jaggies/matchbox/images/matchbox_cpu_v20rt.png

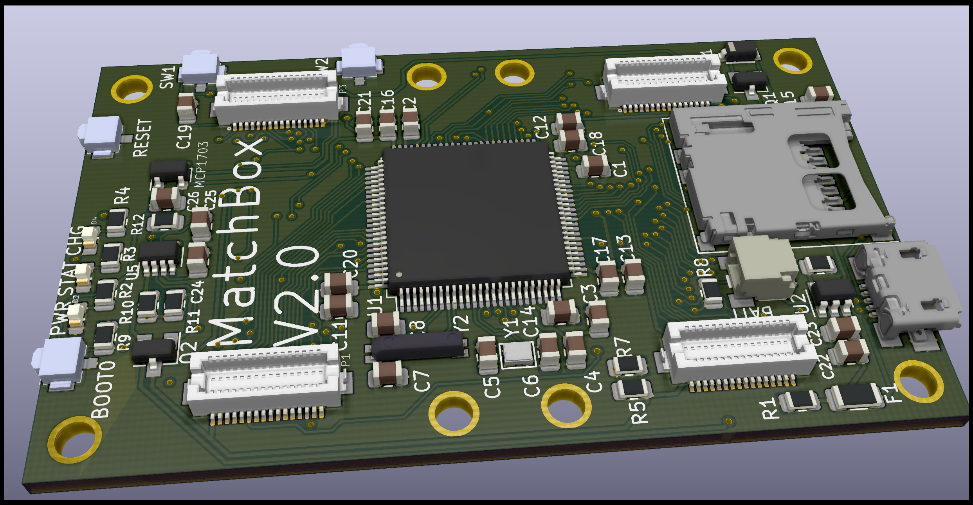
images/matchbox_cpu_v20rt.png
