jaggies/matchbox/images/matchbox_cpu_v20.png

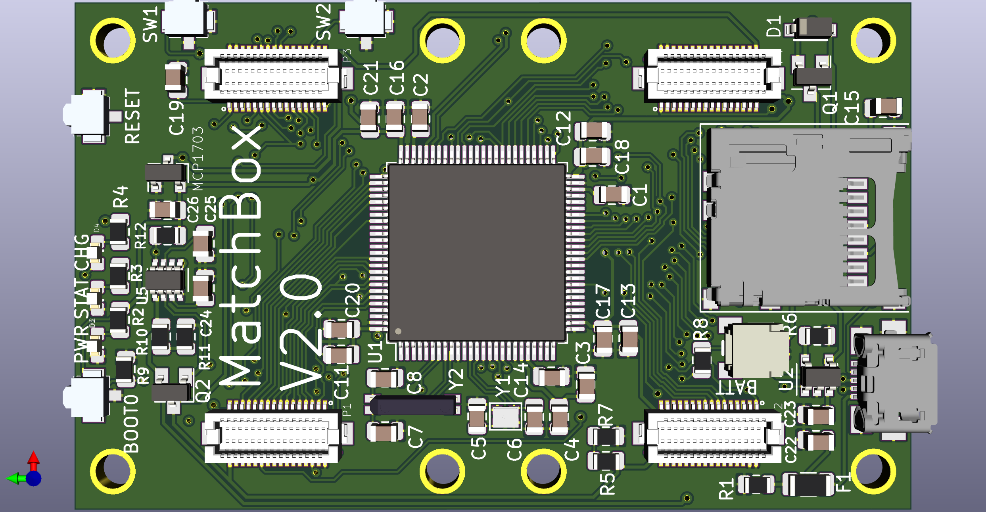
images/matchbox_cpu_v20.png
