jaggies/matchbox/target/stm32f4xx/stm32f415/README

This directory contains the output of STM32CubeMX code generation, less libraries that
are build by the rest of the build system.
