jaggies/matchbox/images/drills.png

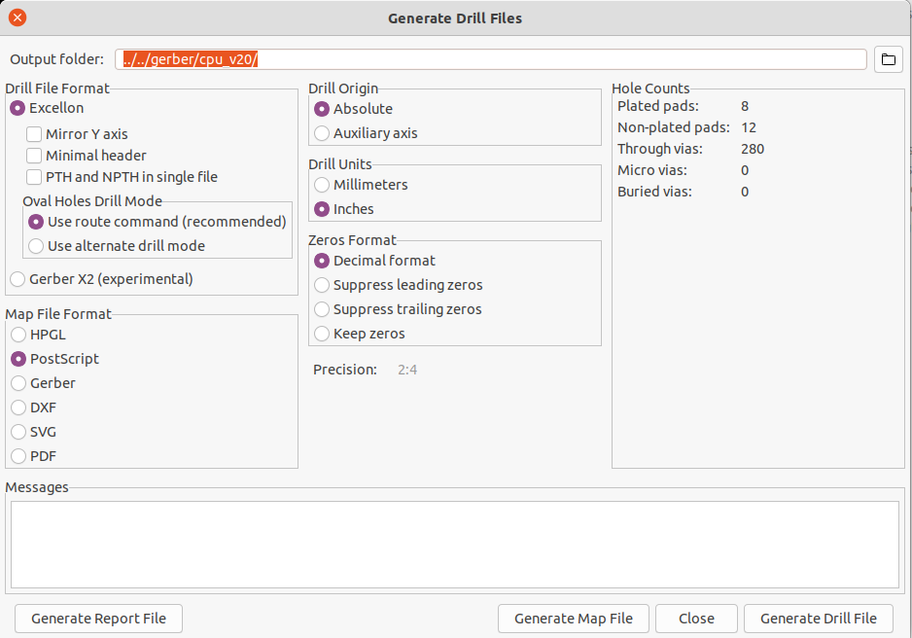
images/drills.png
