jaggies/matchbox/images/gerber.png

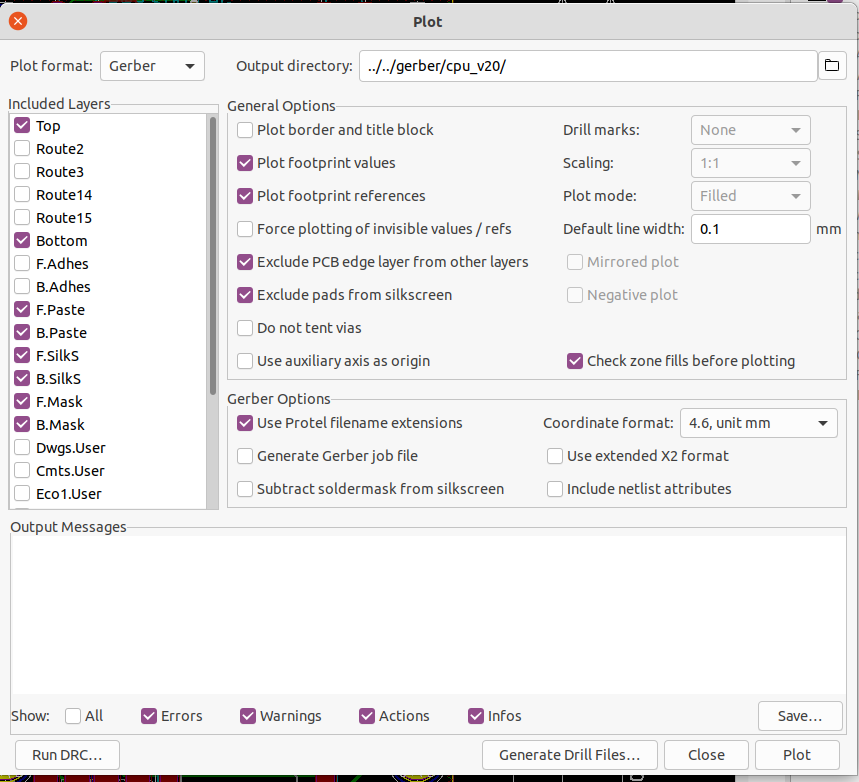
images/gerber.png
