jaggies/matchbox/cad/case/no_battery.FCStd

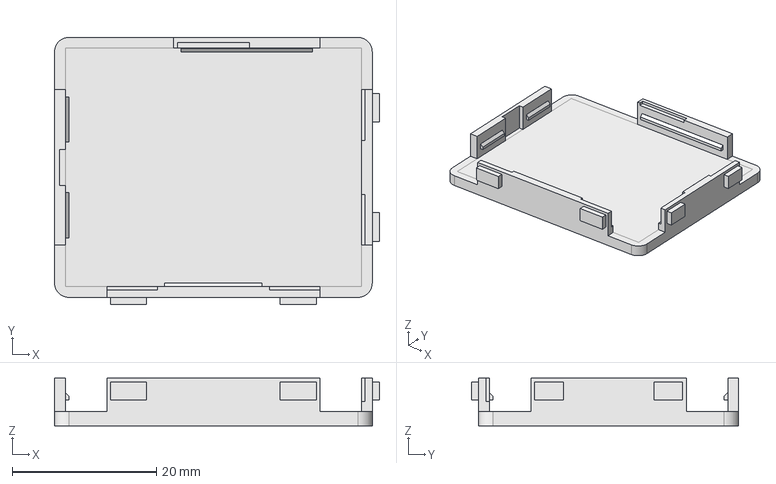
[picture p5: CAD file, 2020-05-25]
cad/case/no_battery.FCStd
45.0 x 37.0 x 6.60 mm
