jaggies/matchbox/cad/pcb/kicad/3dshapes/ABM11.STEP

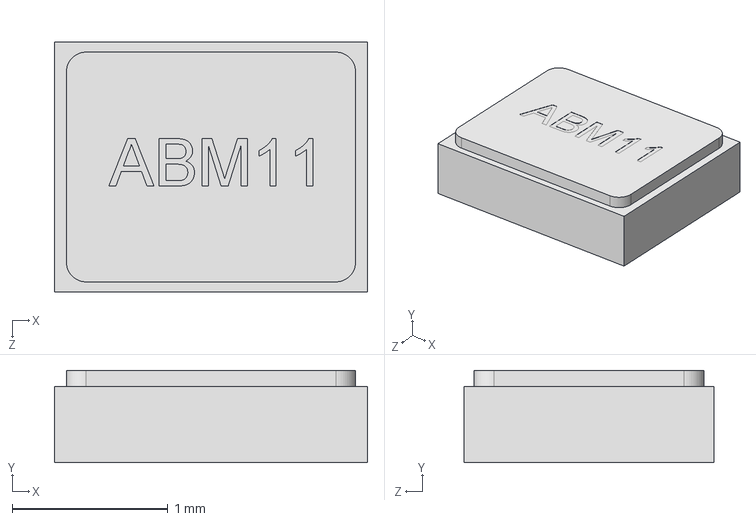
[picture p6: CAD file, 2020-07-05]
cad/pcb/kicad/3dshapes/ABM11.STEP
2.01 x 0.59 x 1.60 mm
