jaggies/matchbox/cad/case/new_corner.FCStd

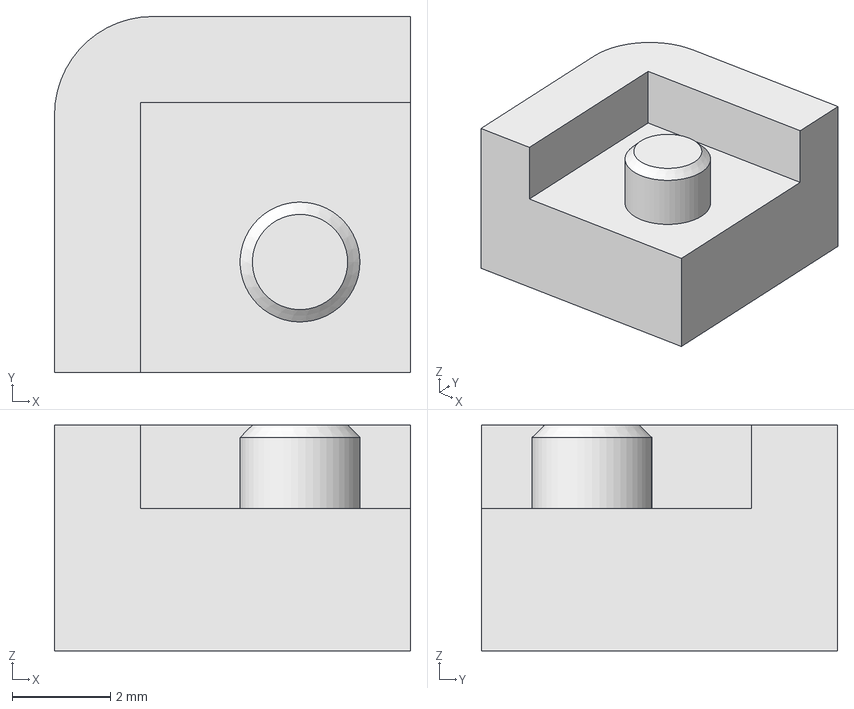
[picture p7: CAD file, 2020-05-25]
cad/case/new_corner.FCStd
7.25 x 7.25 x 4.60 mm
