jaggies/matchbox/cad/pcb/kicad/3dshapes/DF12-32DS-0.5V.stp

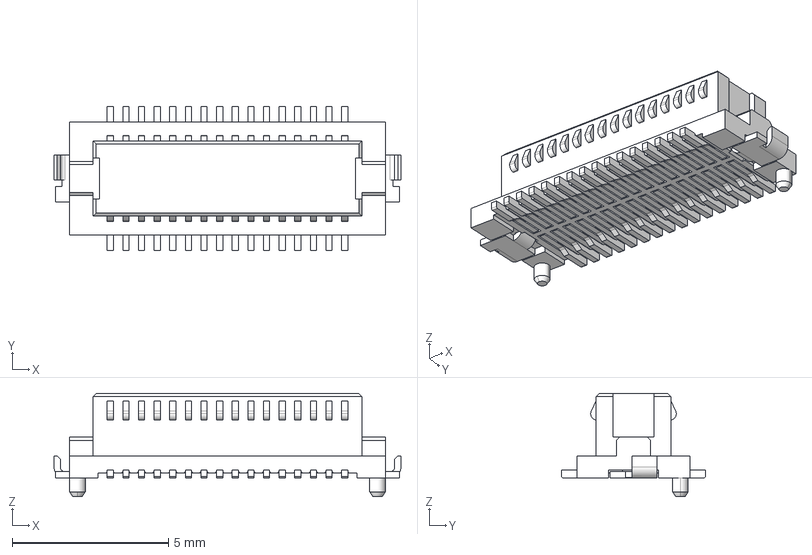
[picture p8: CAD file, 2020-07-05]
cad/pcb/kicad/3dshapes/DF12-32DS-0.5V.stp
11.1 x 4.60 x 3.30 mm
