jaggies/matchbox/cad/case/peg_corner.FCstd

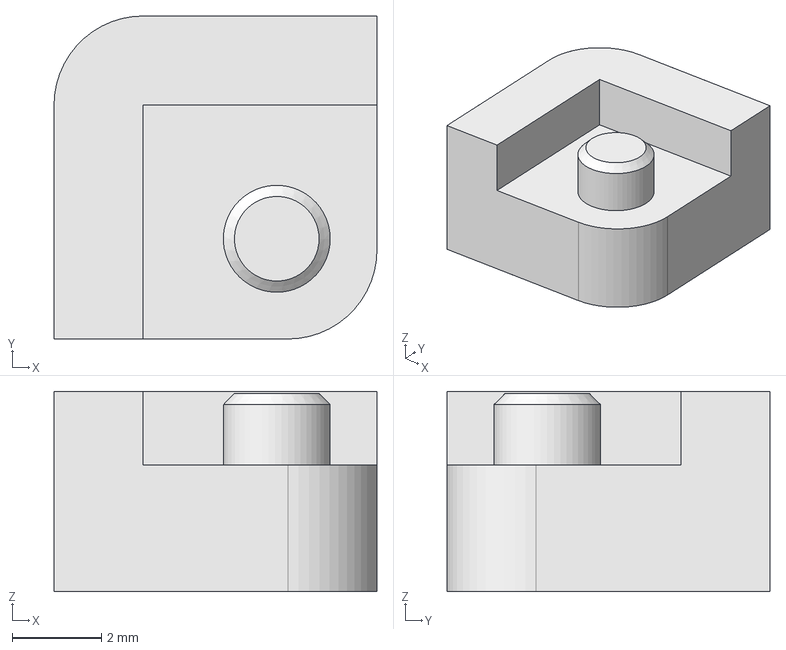
[picture p9: CAD file, 2020-05-25]
cad/case/peg_corner.FCstd
7.25 x 7.25 x 4.50 mm
