jaggies/matchbox/cad/pcb/kicad/3dshapes/SM02B-SRSS-TB_white.STEP

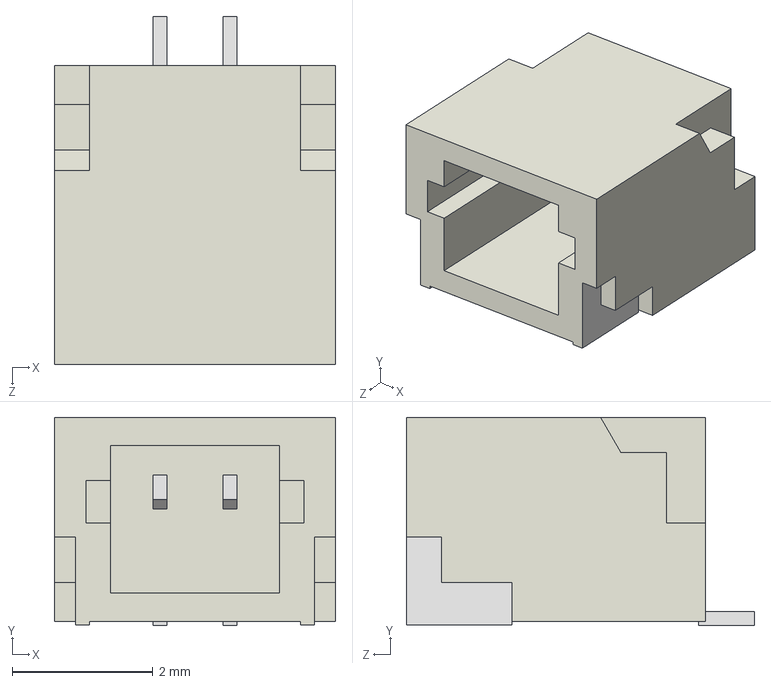
[picture p10: CAD file, 2020-07-05]
cad/pcb/kicad/3dshapes/SM02B-SRSS-TB_white.STEP
4.00 x 2.96 x 4.95 mm
