jaggies/matchbox/cad/case/display.FCStd

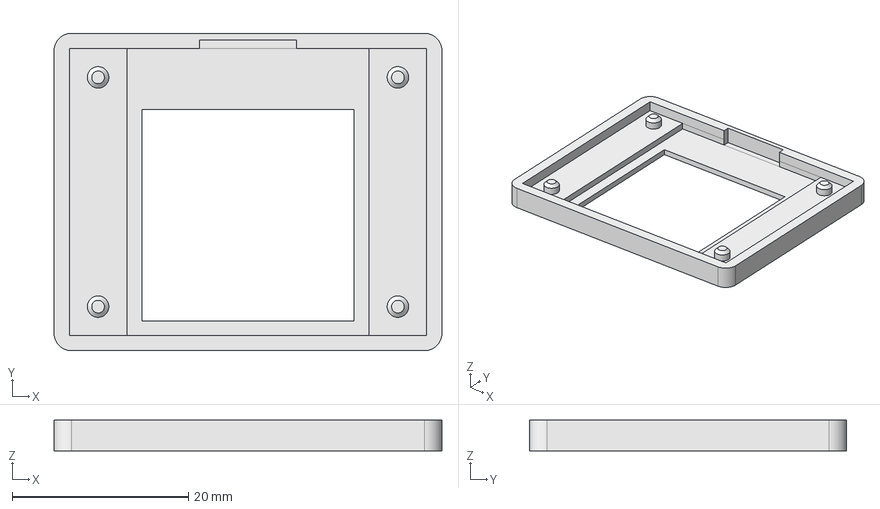
[picture p11: CAD file, 2020-05-25]
cad/case/display.FCStd
44.0 x 36.0 x 3.50 mm
