jaggies/matchbox/cad/case/new_battery.FCStd

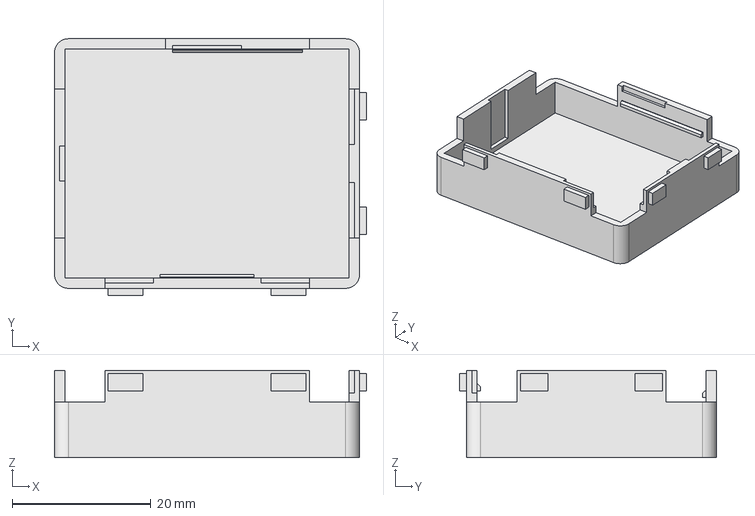
[picture p12: CAD file, 2020-05-25]
cad/case/new_battery.FCStd
45.0 x 37.0 x 12.6 mm
