jaggies/matchbox/cad/pcb/kicad/3dshapes/DF12(3.0)-32DP-0.5V.stp

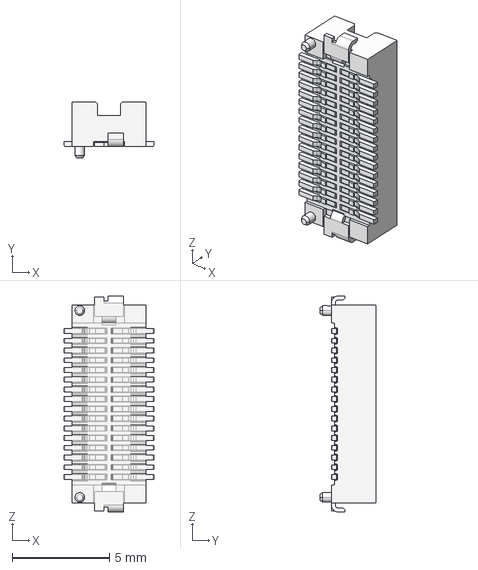
[picture p13: CAD file, 2020-07-05]
cad/pcb/kicad/3dshapes/DF12(3.0)-32DP-0.5V.stp
4.60 x 2.90 x 11.1 mm
