jaggies/matchbox/cad/pcb/kicad/3dshapes/b3u_B3U-3100P(M)-B.igs

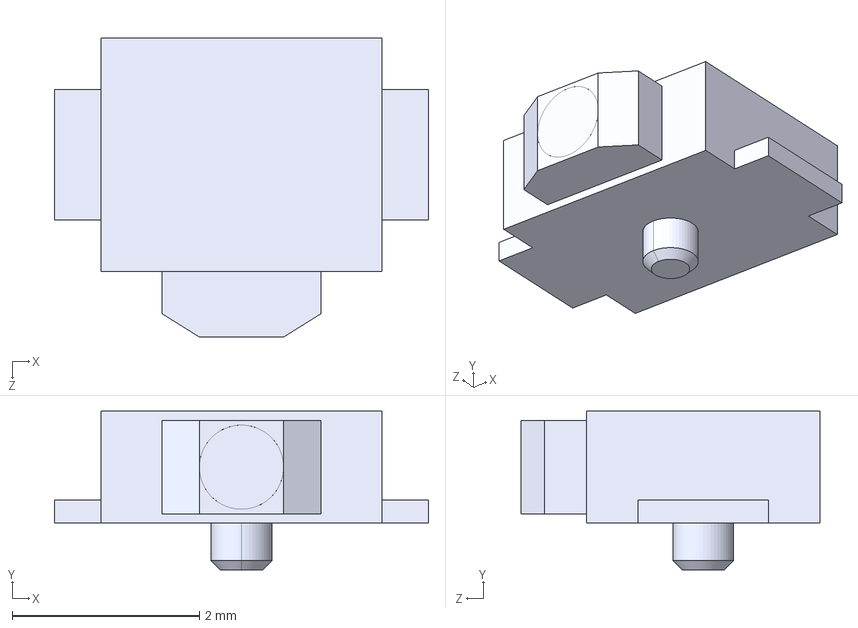
[picture p14: CAD file, 2020-07-05]
cad/pcb/kicad/3dshapes/b3u_B3U-3100P(M)-B.igs
4.00 x 1.70 x 3.20 mm
