jaggies/matchbox/cad/pcb/kicad/3dshapes/10118192C.stp

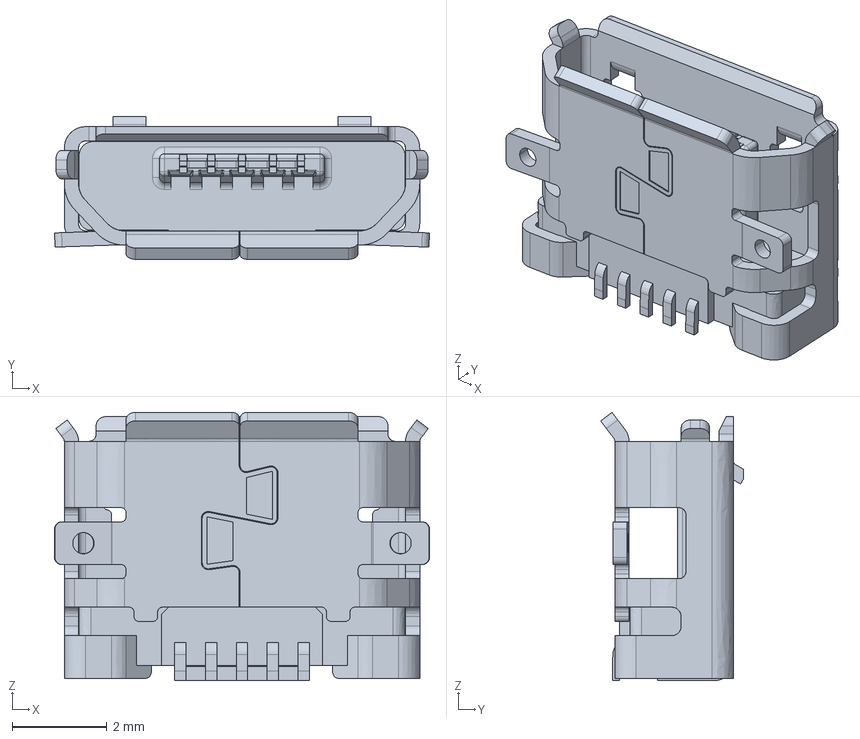
[picture p15: CAD file, 2020-07-05]
cad/pcb/kicad/3dshapes/10118192C.stp
7.91 x 3.01 x 5.66 mm
