jaggies/matchbox/cad/pcb/kicad/3dshapes/5025700893.stp

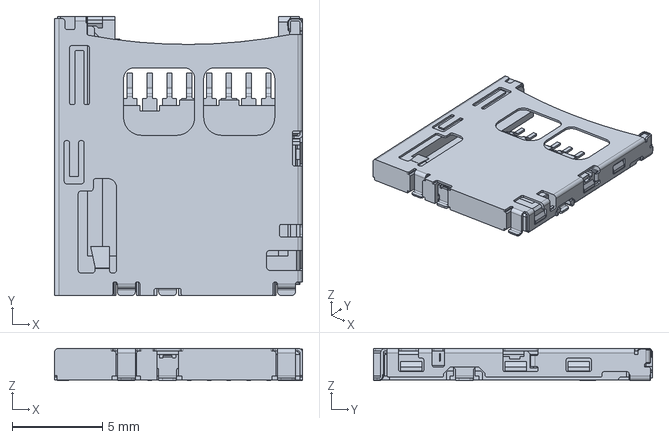
[picture p16: CAD file, 2020-07-05]
cad/pcb/kicad/3dshapes/5025700893.stp
13.8 x 15.5 x 1.80 mm
