jaggies/matchbox/(list of files, cad)

Other CAD files:
cad/pcb/kicad/3dshapes/SM02B-SRSS-TB.STEP
cad/case/battery.FCStd
cad/case/screw_corner.FCStd
cad/pcb/kicad/3dshapes/SM02B-SRSS-TB.IGS
