jaggies/matchbox/cad/pcb/kicad/cpu/v2.0/matchbox_cpu_v20.kicad_pcb

## KiCad design cad/pcb/kicad/cpu/v2.0/matchbox_cpu_v20.kicad_pcb (2020-07-22)

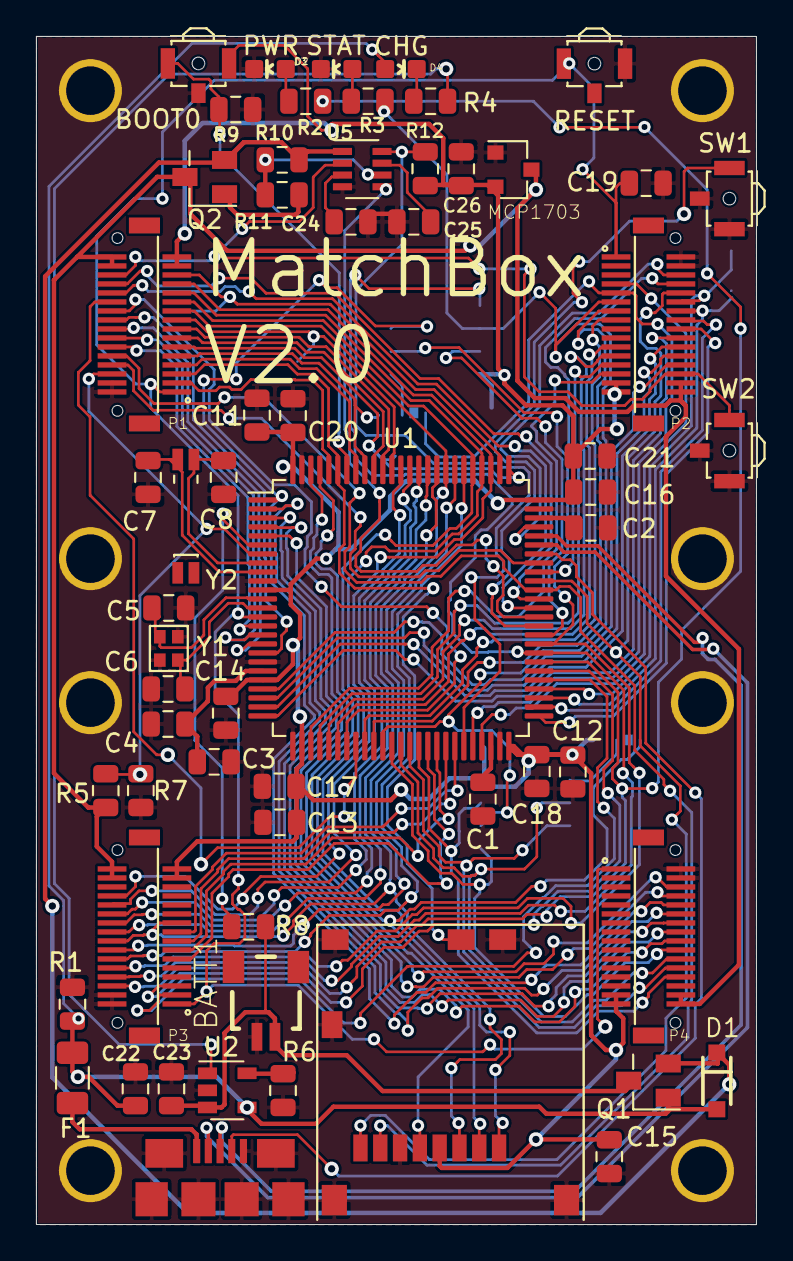
[picture p17: board matchbox_cpu_v20.kicad_pcb from above]

Board: 6 copper layers, 40.0 x 66.0 mm, 75 parts (0 on the bottom side), 107 nets.

Parts:
BATT1: SM02B-SRSS-TBS; SM02B-SRSS-TB
C1, C2: 2.2uF; C_0805_2012Metric
C3, C9, C10, C11, C12, C13, C15, C21, C25, C26: 1uF; C_0805_2012Metric
C4, C14, C16, C17, C18, C19, C20: 0.1uF; C_0805_2012Metric
C5, C6: 4pF; C_0805_2012Metric
C7, C8: 8pF; C_0805_2012Metric
C22, C23: 10uF; C_0805_2012Metric
C24: .033uF; C_0805_2012Metric
D1: MBR120; SOD-123
D2: PWR; LED-0603
D3: STAT; LED-0603
D4: CHG; LED-0603
F1: PTCTHERMISTOR1206; R_1206_3216Metric
JP1: BANK1_SEL; SolderJumper-3_P1.3mm_Bridged12_Pad1.0x1.5mm_NumberLabels
JP2: BANK2_SEL; SolderJumper-3_P1.3mm_Bridged12_Pad1.0x1.5mm_NumberLabels
P1, P2, P3, P4: DF12-32-DP
Q1, Q2: FDN360P; SuperSOT-3
R1, R6: 4.7k; R_0805_2012Metric
R2, R3, R4: 1k; R_0805_2012Metric
R5, R7, R9, R12: 10k; R_0805_2012Metric
R8, R10, R11: 100k; R_0805_2012Metric
SD1: MOLEX_MICROSD_PP
SW0: BOOT0; B3U-3100PM-B
SW1, SW2: B3U-3100PM-B
SW3: RESET; B3U-3100PM-B
TP1: VCC_3V3; TestPoint_Pad_D1.5mm
TP2: GND; TestPoint_Pad_D1.5mm
TP3: RESET; TestPoint_Pad_D1.5mm
TP4: SWDCLK/TCK; TestPoint_Pad_D1.5mm
TP5: SWDIO/TMS; TestPoint_Pad_D1.5mm
TP6: SWO/TDO; TestPoint_Pad_D1.5mm
TP7: TDI; TestPoint_Pad_D1.5mm
TP8: TX; TestPoint_Pad_D1.5mm
TP9: RX; TestPoint_Pad_D1.5mm
U1: STM32H753VITx; LQFP-100_14x14mm_P0.5mm
U2: MCP73831-2-OT; SOT-23-5
U3: BANK1; SOIC-8_3.9x4.9mm_P1.27mm
U4: BANK2; SOIC-8_3.9x4.9mm_P1.27mm
U5: LTC2954; SOT-23-8
U6: MCP1703; SOT-23
USB1: MICROUSB
Y1: 16MHz(9pF); ABM11
Y2: 32.768kHz (9pF); CRYSTAL-32KHZ-SMD_EPSON_MC146

Connections:
/BANK1_CS#: JP1.2, U3.1
/BANK2_CS#: JP2.2, U4.1
/BOOT0: R9.1, SW0.1, U1.94
/OSC32K_IN: C8.1, U1.8, Y2.P$2
/OSC32K_OUT: C7.1, U1.9, Y2.P$1
/OSC_IN: C5.1, U1.12, Y1.1
/OSC_OUT: C6.1, U1.13, Y1.3
/PA0: P2.26, U1.22
/PA1: P2.24, U1.23
/PA2: P2.22, U1.24
/PA3: P2.20, U1.25
/PA4: P2.27, U1.28
/PA5: P2.25, U1.29
/PA6: P2.23, U1.30
/PA7: P2.21, U1.31
/PA8: P2.8, U1.67
/PA9: P1.8, U1.68
/PA13: P2.6, TP5.1, U1.72
/PA14: P1.11, TP4.1, U1.76
/PA15: P1.27, TP7.1, U1.77
/PB0: P2.15, U1.34
/PB1: P2.13, U1.35
/PB2: P2.11, R3.2, U1.36, U3.6, U4.6
/PB3: P1.17, TP6.1, U1.89
/PB4: P1.15, U1.90
/PB5: P1.13, U1.91
/PB6: JP1.3, P1.9, U1.92
/PB7: P1.7, U1.93
/PB8: P1.5, SD1.DET, U1.95
/PB9: P1.3, U1.96
/PB10: JP1.1, P2.9, U1.46
/PB11: P2.7, U1.47
/PB12: P2.18, U1.51
/PB13: P2.16, U1.52
/PB14: P2.14, TP8.1, U1.53
/PB15: P2.12, TP9.1, U1.54
/PC0: P1.12, U1.15
/PC1: P1.14, U1.16
/PC2: P1.16, U1.17
/PC3: P1.18, U1.18
/PC4: P1.20, U1.32
/PC5: P1.22, U1.33
/PC6: P1.24, U1.63
/PC7: P1.26, U1.64
/PC8: P1.10, SD1.7, U1.65
/PC9: P2.10, SD1.8, U1.66
/PC10: P1.25, SD1.1, U1.78
/PC11: JP2.1, P1.23, SD1.2, U1.79
/PC12: P1.21, SD1.5, U1.80
/PC13: P1.6, R5.2, R7.1, U1.7
/PD0: P3.12, U1.81
/PD1: P3.14, U1.82
/PD2: P1.19, P3.16, P3.19, SD1.3, U1.83
/PD3: P3.18, U1.84
/PD4: P3.20, U1.85
/PD5: P3.22, U1.86
/PD6: P3.24, U1.87
/PD7: P3.26, U1.88
/PD8: P3.3, U1.55
/PD9: P3.5, U1.56
/PD10: P3.6, R2.2, U1.57
/PD11: P3.8, U1.58, U3.5
/PD12: P3.10, U1.59, U3.2
/PD13: U1.60, U3.7
/PD14: SW1.1, U1.61
/PD15: U1.62, U5.5
/PE0: P4.6, U1.97
/PE1: P4.8, U1.98
/PE2: P4.10, U1.1, U3.3
/PE3: P4.12, U1.2
/PE4: P4.14, U1.3
/PE5: P4.16, U1.4
/PE6: P4.18, U1.5
/PE7: P4.20, U1.37, U4.5
/PE8: P4.22, U1.38, U4.2
/PE9: P4.24, U1.39, U4.3
/PE10: P4.26, U1.40, U4.7
/PE11: P3.11, U1.41
/PE12: P3.13, U1.42
/PE13: P3.15, U1.43
/PE14: P3.17, U1.44
/PE15: R12.1, U1.45, U5.8
/PWR_ON: P1.28, P2.28, SW2.1, U5.2
/RESET#: C19.1, P1.1, P2.1, P3.1, P4.1, SW3.1, TP3.1, U1.14
/STAT: R4.2, U2.1
/USB_D+: U1.71, USB1.3
/USB_D-: U1.70, USB1.2
/USB_ID: U1.69, USB1.4
/VBAT: BATT1.1, C23.1, Q1.3, R8.1, U2.3
/VCC: P1.30, P1.32, P2.30, P2.32, P3.30, P3.32, P4.30, P4.32, Q2.3, R5.1, U6.3
/VCC_3V3: C9.1, C10.1, C11.1, C12.1, C13.1, C14.1, C15.1, C16.1, C17.1, C18.1, C20.1, C21.1, C26.1, JP2.3, P1.29, P1.31, P2.29, P2.31, P3.29, P3.31, P4.29, P4.31, R12.2, SD1.4, SW0.2, TP1.1, U1.11, U1.21, U1.27, U1.50, U1.75, U1.100, U3.8, U4.8, U6.2
/VCC_BKUP: R8.2, U1.6
/VCC_SEL: D1.C, Q1.2, Q2.2, R10.1, U5.1
/VCC_USB: F1.1, USB1.1
/VCC_USBF: C22.1, D1.A, D4.A, F1.2, Q1.1, R1.1, U2.4
/VREF: C3.1, C4.1, U1.20
GND: BATT1.2, C1.1, C2.1, C3.2, C4.2, C5.2, C6.2, C7.2, C8.2, C9.2, C10.2, C11.2, C12.2, C13.2, C14.2, C15.2, C16.2, C17.2, C18.2, C19.2, C20.2, C21.2, C22.2, C23.2, C24.2, C25.2, C26.2, D2.C, D3.C, P1.2, P1.4, P2.2, P2.4, P3.2, P3.4, P4.2, P4.4, R1.2, R6.1, R7.2, R9.2, SD1.6, SD1.M1, SD1.M2, SD1.M3, SD1.M4, SD1.M5, SW0.GND, SW1.2, SW1.GND, SW2.2, SW2.GND, SW3.2, TP2.1, U1.10, U1.19, U1.26, U1.49, U1.74, U1.99, U2.2, U3.4, U4.4, U5.4, U6.1, USB1.5, USB1.6, USB1.7, USB1.8, USB1.9, USB1.10, USB1.11, Y1.2, Y1.4
unnamed: C1.2, U1.48
unnamed: C2.2, U1.73
unnamed: C24.1, U5.3
unnamed: C25.1, U5.7
unnamed: D2.A, R2.1
unnamed: D3.A, R3.1
unnamed: D4.C, R4.1
unnamed: Q2.1, R11.1
unnamed: R6.2, U2.5
unnamed: R10.2, R11.2, U5.6
