jaggies/matchbox/cad/pcb/kicad/bluetooth/v1.0/matchbox_ble_v10.kicad_pcb

## KiCad design cad/pcb/kicad/bluetooth/v1.0/matchbox_ble_v10.kicad_pcb (2020-07-01)

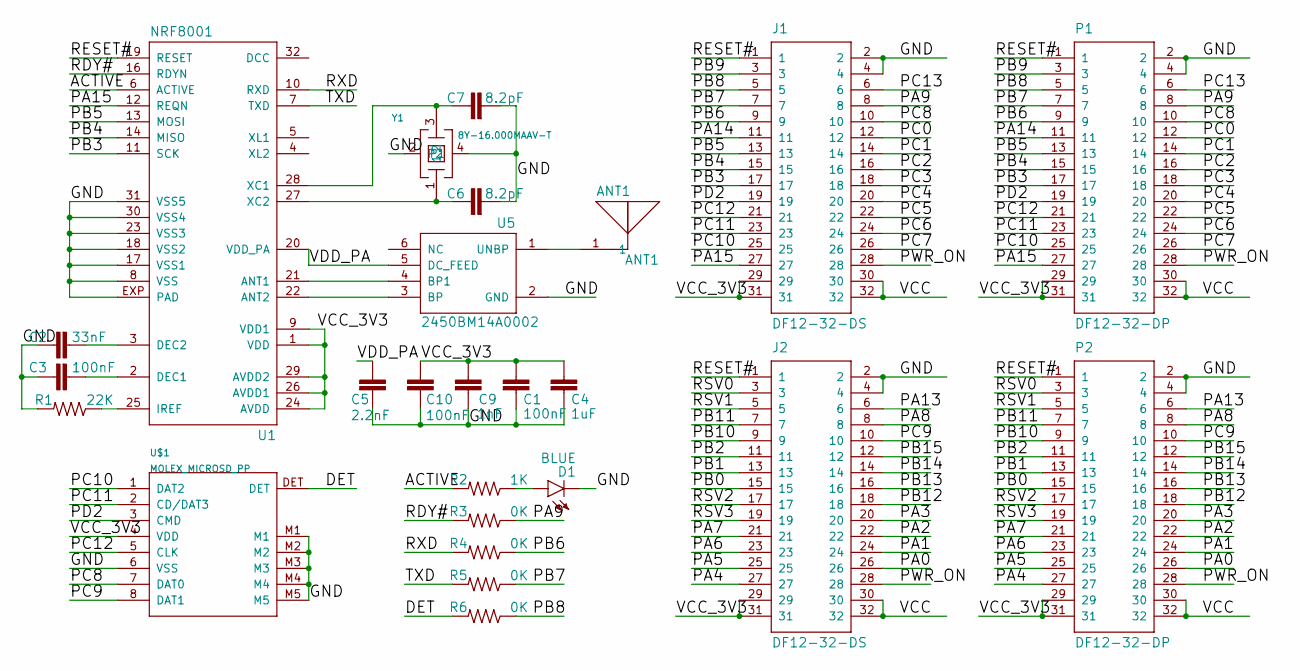
[picture p18: schematic matchbox_ble_v10.sch]

Parts:
ANT1: ANT1; 2450AT18A100; PARTNO AS-ITM-00132
C1, C3, C10: 100nF; 0402-CAP; MPN 1C20Z5U104M050B
C2: 33nF; 0402-CAP
C4: 1uF; 0805
C5: 2.2nF; 0402-CAP
C6, C7: 8.2pF; 0402-CAP
C9: 1nF; 0402-CAP
D1: BLUE; LED-0603
J1, J2: DF12-32-DS
P1, P2: DF12-32-DP
R1: 22K; 0402-RES
R2: 1K; 0805
R3, R4, R5, R6: 0K; 0805
U1: NRF8001; ATMEL_QFN32
U5: 2450BM14A0002
U$1: MOLEX_MICROSD_PP
Y1: 8Y-16.000MAAV-T; ABM11; PARTNO AS-ITM-00228

Connections:
/ACTIVE: R2.2, U1.6 (ACTIVE)
/DET: R6.2, U$1.DET
/GND: C1.2, C2.2, C3.2, C4.2, C5.2, C6.2, C7.2, C9.2, C10.2, D1.C, J1.2, J1.4, J2.2, J2.4, P1.2, P1.4, P2.2, P2.4, R1.2, U1.8 (VSS), U1.17 (VSS1), U1.18 (VSS2), U1.23 (VSS3), U1.30 (VSS4), U1.31 (VSS5), U1.EXP (PAD), U5.2 (GND), U$1.6 (VSS), U$1.M1, U$1.M2, U$1.M3, U$1.M4, U$1.M5, Y1.2, Y1.4 (P1)
/PA0: J2.26, P2.26
/PA1: J2.24, P2.24
/PA2: J2.22, P2.22
/PA3: J2.20, P2.20
/PA4: J2.27, P2.27
/PA5: J2.25, P2.25
/PA6: J2.23, P2.23
/PA7: J2.21, P2.21
/PA8: J2.8, P2.8
/PA9: J1.8, P1.8, R3.1
/PA13: J2.6, P2.6
/PA14: J1.11, P1.11
/PA15: J1.27, P1.27, U1.12 (REQN)
/PB0: J2.15, P2.15
/PB1: J2.13, P2.13
/PB2: J2.11, P2.11
/PB3: J1.17, P1.17, U1.11 (SCK)
/PB4: J1.15, P1.15, U1.14 (MISO)
/PB5: J1.13, P1.13, U1.13 (MOSI)
/PB6: J1.9, P1.9, R4.1
/PB7: J1.7, P1.7, R5.1
/PB8: J1.5, P1.5, R6.1
/PB9: J1.3, P1.3
/PB10: J2.9, P2.9
/PB11: J2.7, P2.7
/PB12: J2.18, P2.18
/PB13: J2.16, P2.16
/PB14: J2.14, P2.14
/PB15: J2.12, P2.12
/PC0: J1.12, P1.12
/PC1: J1.14, P1.14
/PC2: J1.16, P1.16
/PC3: J1.18, P1.18
/PC4: J1.20, P1.20
/PC5: J1.22, P1.22
/PC6: J1.24, P1.24
/PC7: J1.26, P1.26
/PC8: J1.10, P1.10, U$1.7 (DAT0)
/PC9: J2.10, P2.10, U$1.8 (DAT1)
/PC10: J1.25, P1.25, U$1.1 (DAT2)
/PC11: J1.23, P1.23, U$1.2 (CD/DAT3)
/PC12: J1.21, P1.21, U$1.5 (CLK)
/PC13: J1.6, P1.6
/PD2: J1.19, P1.19, U$1.3 (CMD)
/PWR_ON: J1.28, J2.28, P1.28, P2.28
/RDY#: R3.2, U1.16 (RDYN)
/RESET#: J1.1, J2.1, P1.1, P2.1, U1.19 (RESET)
/RSV0: J2.3, P2.3
/RSV1: J2.5, P2.5
/RSV2: J2.17, P2.17
/RSV3: J2.19, P2.19
/RXD: R4.2, U1.10 (RXD)
/TXD: R5.2, U1.7 (TXD)
/VCC: J1.30, J1.32, J2.30, J2.32, P1.30, P1.32, P2.30, P2.32
/VCC_3V3: C1.1, C4.1, C9.1, C10.1, J1.29, J1.31, J2.29, J2.31, P1.29, P1.31, P2.29, P2.31, U1.1 (VDD), U1.9 (VDD1), U1.24 (AVDD), U1.26 (AVDD1), U1.29 (AVDD2), U$1.4 (VDD)
/VDD_PA: C5.1, U1.20 (VDD_PA), U5.5 (DC_FEED)
unnamed: ANT1.1, U5.1 (UNBP)
unnamed: C2.1, U1.3 (DEC2)
unnamed: C3.1, U1.2 (DEC1)
unnamed: C6.1, U1.27 (XC2), Y1.1
unnamed: C7.1, U1.28 (XC1), Y1.3 (2)
unnamed: D1.A, R2.1
unnamed: R1.1, U1.25 (IREF)
unnamed: U1.21 (ANT1), U5.4 (BP1)
unnamed: U1.22 (ANT2), U5.3 (BP)

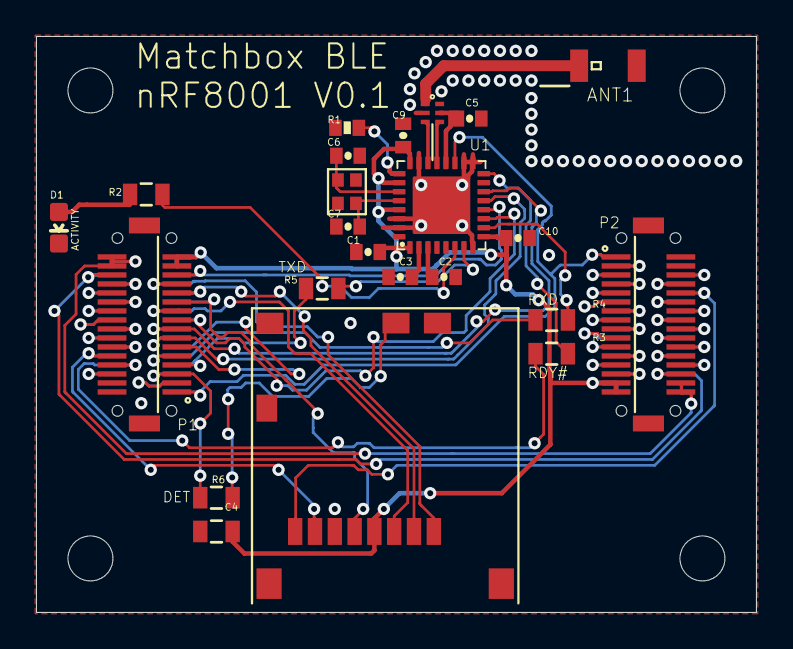
[picture p19: board matchbox_ble_v10.kicad_pcb from above]

Board: 2 copper layers, 40.0 x 32.0 mm, 29 parts (0 on the bottom side), 68 nets.

Other parts of the board:
@HOLE0, @HOLE1, @HOLE2, @HOLE3: (no value)
