jaggies/matchbox/cad/pcb/eagle/display/matchbox_dpy_sm_v11.brd

## EAGLE design cad/pcb/eagle/display/matchbox_dpy_sm_v11.brd (2020-06-06)

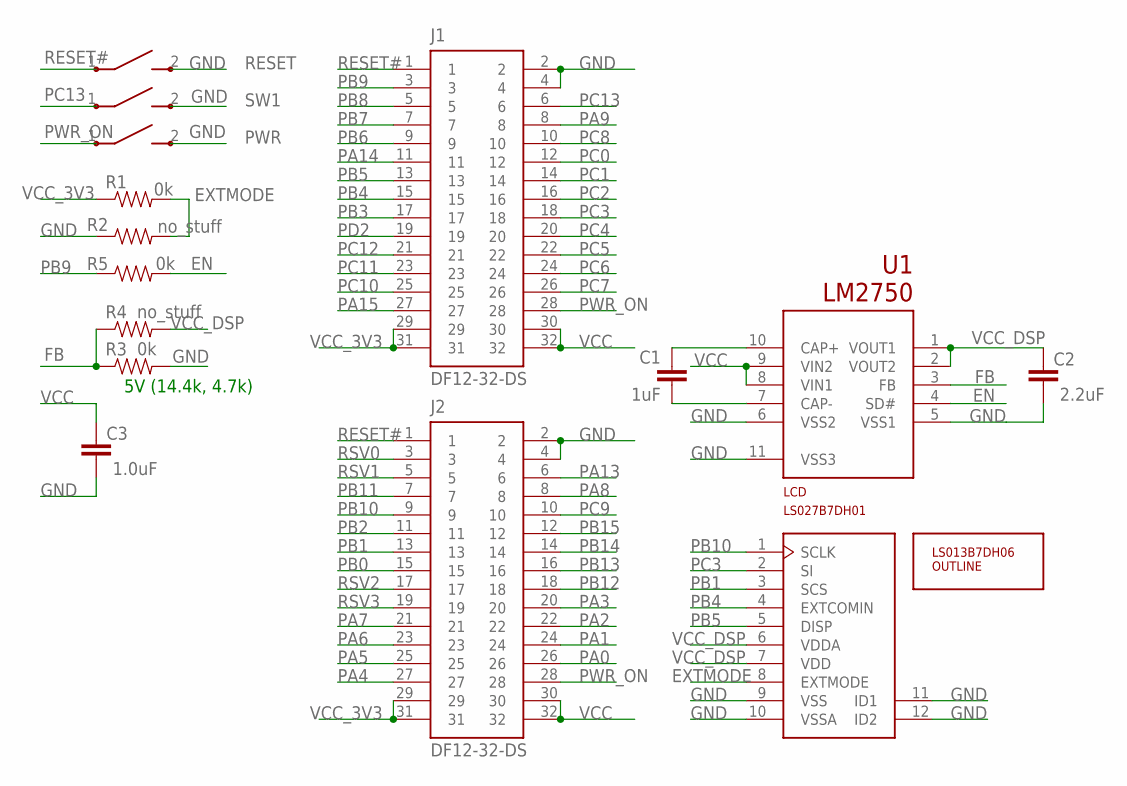
[picture p23: schematic matchbox_dpy_sm_v11.sch]

Parts:
C1: 1uF; 0805; MPN 106K050CS4
C2: 2.2uF; 0805; MPN 106K050CS4
C3: 1.0uF; 0805; MPN 106K050CS4
J1, J2: DF12-32-DS
LCD: LS027B7DH01; MOLEX-51441-1093
PWR: B3U-3100PM-B
R1, R3, R5: 0k; 0805
R2, R4: no_stuff; 0805
RESET: B3U-3100PM-B
SW1: B3U-3100PM-B
U1: LM2750
U$1: LS013B7DH06-OUTLINE; LS013B7DH06

Connections:
EN: R5.2, U1.4 (SD#)
EXTMODE: LCD.8 (EXTMODE), R1.2, R2.2
FB: R3.1, R4.1, U1.3 (FB)
GND: C2.2, C3.2, J1.2, J1.4, J2.2, J2.4, LCD.9 (VSS), LCD.10 (VSSA), LCD.11 (ID1), LCD.12 (ID2), PWR.2, PWR.GND, R2.1, R3.2, RESET.2, RESET.GND, SW1.2, SW1.GND, U1.5 (VSS1), U1.6 (VSS2), U1.11 (VSS3)
unnamed: C1.1, U1.10 (CAP+)
unnamed: C1.2, U1.7 (CAP-)
PA0: J2.26
PA1: J2.24
PA2: J2.22
PA3: J2.20
PA4: J2.27
PA5: J2.25
PA6: J2.23
PA7: J2.21
PA8: J2.8
PA9: J1.8
PA13: J2.6
PA14: J1.11
PA15: J1.27
PB0: J2.15
PB1: J2.13, LCD.3 (SCS)
PB2: J2.11
PB3: J1.17
PB4: J1.15, LCD.4 (EXTCOMIN)
PB5: J1.13, LCD.5 (DISP)
PB6: J1.9
PB7: J1.7
PB8: J1.5
PB9: J1.3, R5.1
PB10: J2.9, LCD.1 (SCLK)
PB11: J2.7
PB12: J2.18
PB13: J2.16
PB14: J2.14
PB15: J2.12
PC0: J1.12
PC1: J1.14
PC2: J1.16
PC3: J1.18, LCD.2 (SI)
PC4: J1.20
PC5: J1.22
PC6: J1.24
PC7: J1.26
PC8: J1.10
PC9: J2.10
PC10: J1.25
PC11: J1.23
PC12: J1.21
PC13: J1.6, SW1.1
PD2: J1.19
PWR_ON: J1.28, J2.28, PWR.1
RESET#: J1.1, J2.1, RESET.1
RSV0: J2.3
RSV1: J2.5
RSV2: J2.17
RSV3: J2.19
VCC: C3.1, J1.30, J1.32, J2.30, J2.32, U1.8 (VIN1), U1.9 (VIN2)
VCC_3V3: J1.29, J1.31, J2.29, J2.31, R1.1
VCC_DSP: C2.1, LCD.6 (VDDA), LCD.7 (VDD), R4.2, U1.1 (VOUT1), U1.2 (VOUT2)

Notes on the sheet:
5V (14.4k, 4.7k)

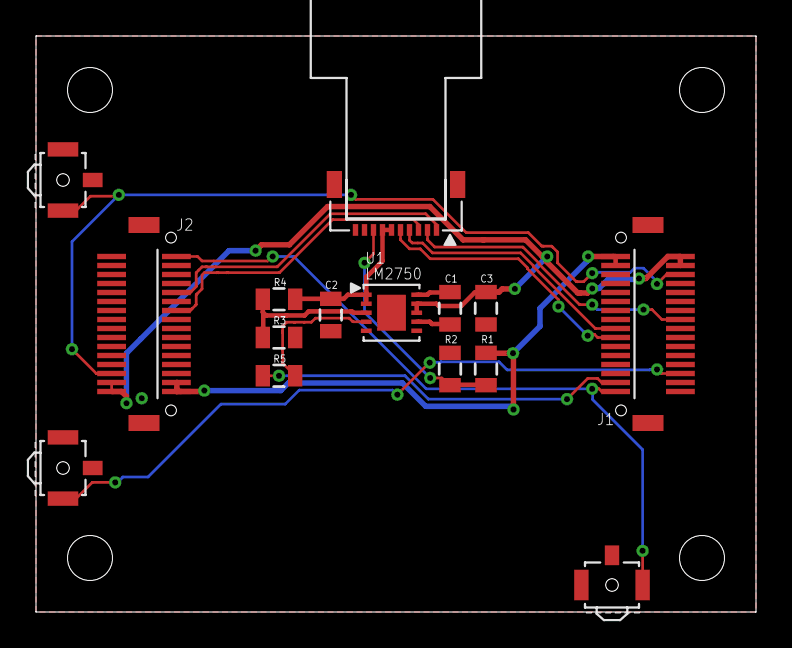
[picture p24: board matchbox_dpy_sm_v11.brd from above]

Board: 2 copper layers, 40.0 x 32.0 mm, 16 parts (0 on the bottom side), 18 nets.
