jaggies/matchbox/cad/pcb/eagle/breakout/matchbox_bob_v11.brd

## EAGLE design cad/pcb/eagle/breakout/matchbox_bob_v11.brd (2020-06-06)

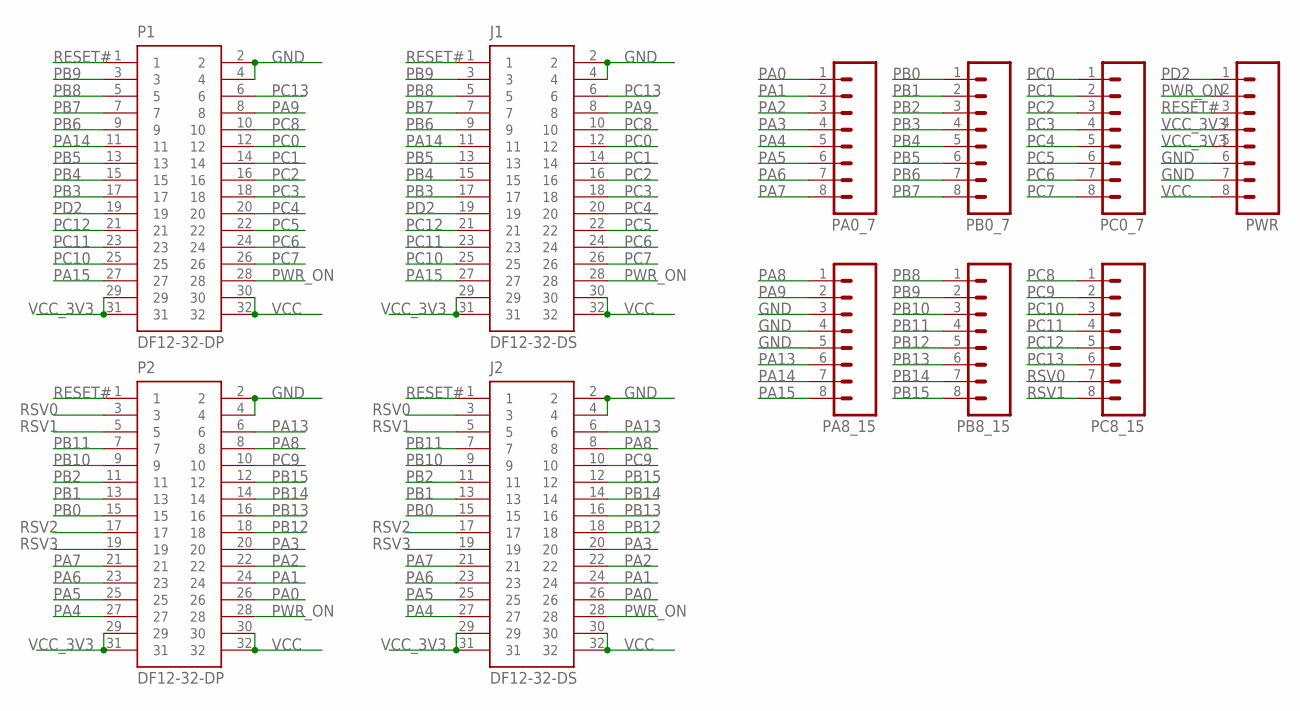
[picture p25: schematic matchbox_bob_v11.sch]

Parts:
J1, J2: DF12-32-DS
P1, P2: DF12-32-DP
PA0_7, PA8_15: M08FEMALE_LOCK; 1X08_FEMALE_LOCK
PB0_7, PB8_15: M08FEMALE_LOCK; 1X08_FEMALE_LOCK
PC0_7, PC8_15: M08FEMALE_LOCK; 1X08_FEMALE_LOCK
PWR: M08FEMALE_LOCK; 1X08_FEMALE_LOCK

Connections:
GND: J1.2, J1.4, J2.2, J2.4, P1.2, P1.4, P2.2, P2.4, PA8_15.3, PA8_15.4, PA8_15.5, PWR.6, PWR.7
PA0: J2.26, P2.26, PA0_7.1
PA1: J2.24, P2.24, PA0_7.2
PA2: J2.22, P2.22, PA0_7.3
PA3: J2.20, P2.20, PA0_7.4
PA4: J2.27, P2.27, PA0_7.5
PA5: J2.25, P2.25, PA0_7.6
PA6: J2.23, P2.23, PA0_7.7
PA7: J2.21, P2.21, PA0_7.8
PA8: J2.8, P2.8, PA8_15.1
PA9: J1.8, P1.8, PA8_15.2
PA13: J2.6, P2.6, PA8_15.6
PA14: J1.11, P1.11, PA8_15.7
PA15: J1.27, P1.27, PA8_15.8
PB0: J2.15, P2.15, PB0_7.1
PB1: J2.13, P2.13, PB0_7.2
PB2: J2.11, P2.11, PB0_7.3
PB3: J1.17, P1.17, PB0_7.4
PB4: J1.15, P1.15, PB0_7.5
PB5: J1.13, P1.13, PB0_7.6
PB6: J1.9, P1.9, PB0_7.7
PB7: J1.7, P1.7, PB0_7.8
PB8: J1.5, P1.5, PB8_15.1
PB9: J1.3, P1.3, PB8_15.2
PB10: J2.9, P2.9, PB8_15.3
PB11: J2.7, P2.7, PB8_15.4
PB12: J2.18, P2.18, PB8_15.5
PB13: J2.16, P2.16, PB8_15.6
PB14: J2.14, P2.14, PB8_15.7
PB15: J2.12, P2.12, PB8_15.8
PC0: J1.12, P1.12, PC0_7.1
PC1: J1.14, P1.14, PC0_7.2
PC2: J1.16, P1.16, PC0_7.3
PC3: J1.18, P1.18, PC0_7.4
PC4: J1.20, P1.20, PC0_7.5
PC5: J1.22, P1.22, PC0_7.6
PC6: J1.24, P1.24, PC0_7.7
PC7: J1.26, P1.26, PC0_7.8
PC8: J1.10, P1.10, PC8_15.1
PC9: J2.10, P2.10, PC8_15.2
PC10: J1.25, P1.25, PC8_15.3
PC11: J1.23, P1.23, PC8_15.4
PC12: J1.21, P1.21, PC8_15.5
PC13: J1.6, P1.6, PC8_15.6
PD2: J1.19, P1.19, PWR.1
PWR_ON: J1.28, J2.28, P1.28, P2.28, PWR.2
RESET#: J1.1, J2.1, P1.1, P2.1, PWR.3
RSV0: J2.3, P2.3, PC8_15.7
RSV1: J2.5, P2.5, PC8_15.8
RSV2: J2.17, P2.17
RSV3: J2.19, P2.19
VCC: J1.30, J1.32, J2.30, J2.32, P1.30, P1.32, P2.30, P2.32, PWR.8
VCC_3V3: J1.29, J1.31, J2.29, J2.31, P1.29, P1.31, P2.29, P2.31, PWR.4, PWR.5

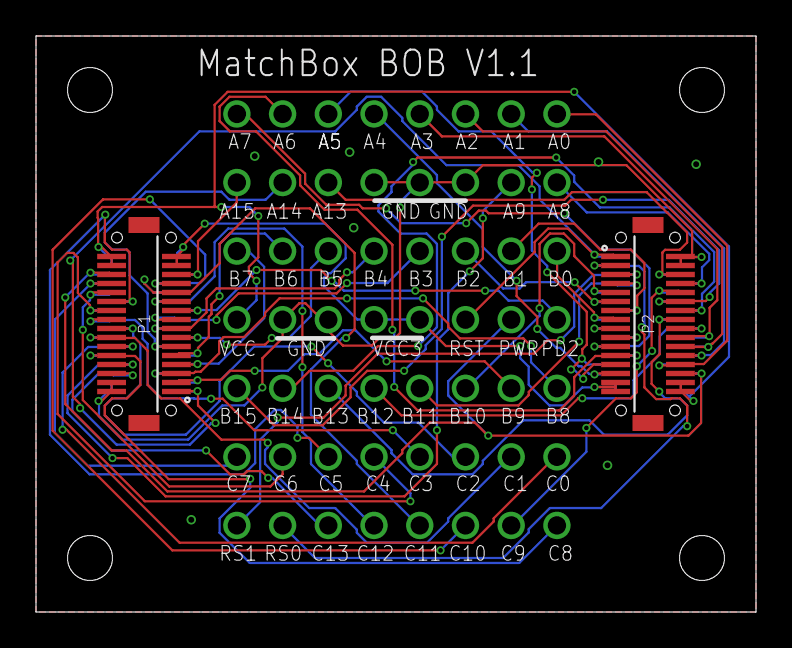
[picture p26: board matchbox_bob_v11.brd from above]

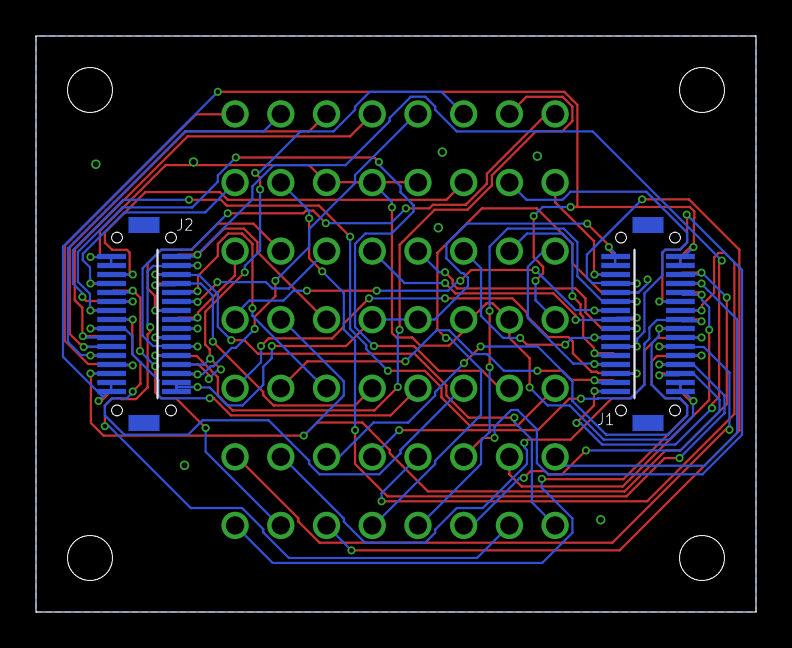
[picture p27: board matchbox_bob_v11.brd from below]

Board: 2 copper layers, 40.0 x 32.0 mm, 11 parts (2 on the bottom side), 53 nets.
