jaggies/matchbox/cad/pcb/eagle/cpu/v1.0/matchbox_cpu_v10.brd

## EAGLE design cad/pcb/eagle/cpu/v1.0/matchbox_cpu_v10.brd (2020-06-06, an earlier design)

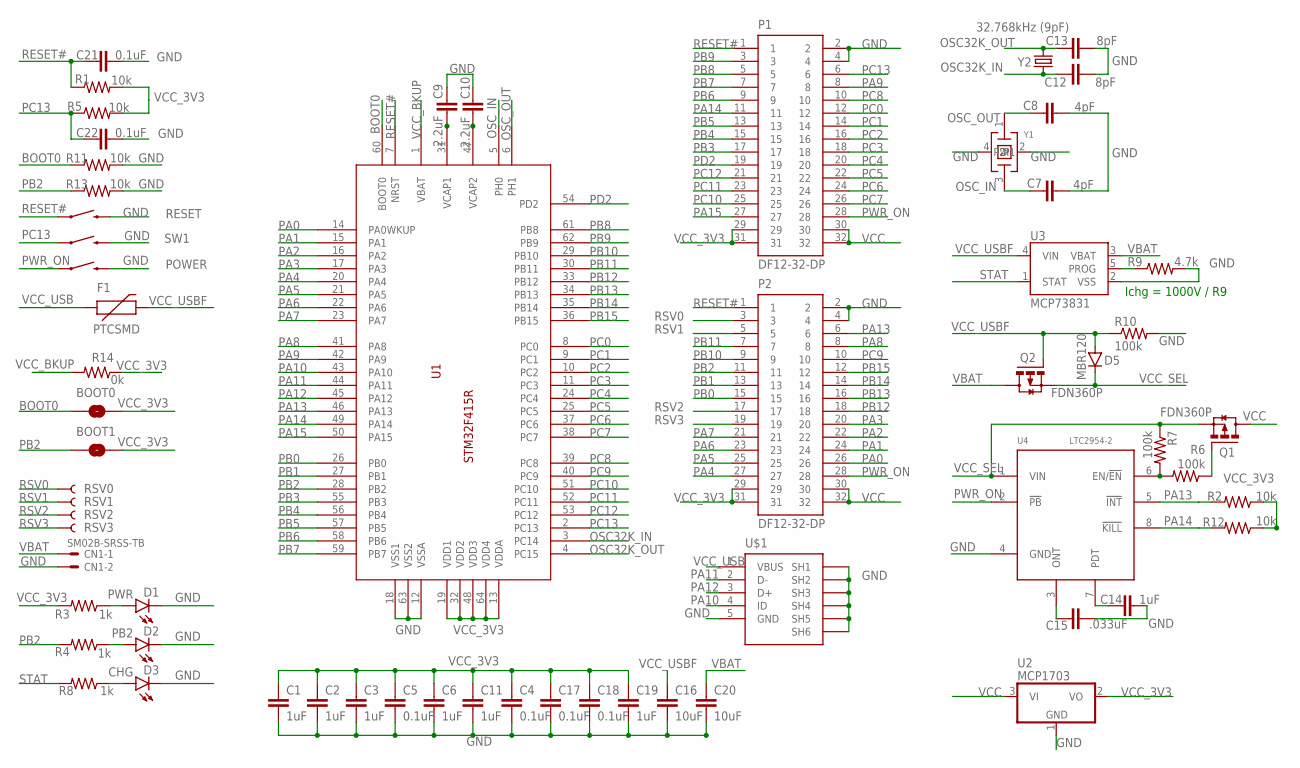
[picture p28: schematic matchbox_cpu_v10.sch]

Parts:
BOOT0, BOOT1: JUMPER-PAD-2-NOYES_SILK; PAD-JUMPER-2-NO_YES_SILK
C1, C2, C3, C6, C11, C14, C19: 1uF; 0805
C4, C5, C17, C18, C21, C22: 0.1uF; 0805
C7, C8: 4pF; 0805
C9, C10: 2.2uF; 0805
C12, C13: 8pF; 0402-CAP
C15: .033uF; 0805
C16, C20: 10uF; 0805
CN1: SM02B-SRSS-TB
D1: PWR; LED-0603
D2: PB2; LED-0603
D3: CHG; LED-0603
D5: MBR120; SOD-123
F1: PTCSMD; PTC-1206
P1, P2: DF12-32-DP
POWER: SWITCH-MOMENTARY-2SMD-REDUNDANT; TACTILE-SWITCH-SMD
Q1, Q2: FDN360P; SUPER-SOT3
R1, R2, R5, R11, R12, R13: 10k; 0805
R3, R4, R8: 1k; 0805
R6, R7, R10: 100k; 0805
R9: 4.7k; 0805
R14: 0k; 0805
RESET: SWITCH-MOMENTARY-2SMD-REDUNDANT; TACTILE-SWITCH-SMD
RSV0, RSV1, RSV2, RSV3: TEST-POINT3; PAD.03X.03
SW1: SWITCH-MOMENTARY-2SMD-REDUNDANT; TACTILE-SWITCH-SMD
U1: STM32F415R; LQFP64
U2: MCP1703; SOT23A
U3: MCP73831; SOT23-5
U4: LTC2954-2; SOT23-8
U$1: MICROUSB
Y1: 16MHz(9pF); ABM11
Y2: 32.768kHz (9pF); CRYSTAL-32KHZ-SMD_EPSON_MC146

Connections:
BOOT0: BOOT0.1, R11.1, U1.60 (BOOT0)
GND: C1.2, C2.2, C3.2, C4.2, C5.2, C6.2, C7.2, C8.2, C9.1, C10.1, C11.2, C12.2, C13.2, C14.2, C15.2, C16.2, C17.2, C18.2, C19.2, C20.2, C21.2, C22.2, CN1.2, D1.C, D2.C, D3.C, P1.2, P1.4, P2.2, P2.4, POWER.3 (2), POWER.4 (2), R9.2, R10.2, R11.2, R13.2, RESET.3 (2), RESET.4 (2), SW1.3 (2), SW1.4 (2), U1.12 (VSSA), U1.18 (VSS1), U1.63 (VSS2), U2.1 (GND), U3.2 (VSS), U4.4 (GND), U$1.5 (GND), U$1.6 (SH1), U$1.7 (SH2), U$1.8 (SH3), U$1.9 (SH4), U$1.10 (SH5), U$1.11 (SH6), Y1.2, Y1.4 (P1)
unnamed: C9.2, U1.31 (VCAP1)
unnamed: C10.2, U1.47 (VCAP2)
unnamed: C15.1, U4.3 (ONT)
unnamed: C14.1, U4.7 (PDT)
unnamed: D1.A, R3.1
unnamed: D2.A, R4.1
unnamed: R6.2, R7.2, U4.6 (EN/!EN!)
unnamed: Q1.1 (G), R6.1
unnamed: D3.A, R8.1
unnamed: R9.1, U3.5 (PROG)
OSC32K_IN: C12.1, U1.3 (PC14), Y2.P$2 (1)
OSC32K_OUT: C13.1, U1.4 (PC15), Y2.P$1 (2)
OSC_IN: C7.1, U1.5 (PH0), Y1.3 (2)
OSC_OUT: C8.1, U1.6 (PH1), Y1.1
PA0: P2.26, U1.14 (PA0WKUP)
PA1: P2.24, U1.15 (PA1)
PA2: P2.22, U1.16 (PA2)
PA3: P2.20, U1.17 (PA3)
PA4: P2.27, U1.20 (PA4)
PA5: P2.25, U1.21 (PA5)
PA6: P2.23, U1.22 (PA6)
PA7: P2.21, U1.23 (PA7)
PA8: P2.8, U1.41 (PA8)
PA9: P1.8, U1.42 (PA9)
PA10: U1.43 (PA10), U$1.4 (ID)
PA11: U1.44 (PA11), U$1.2 (D-)
PA12: U1.45 (PA12), U$1.3 (D+)
PA13: P2.6, R2.2, U1.46 (PA13), U4.5 (!INT!)
PA14: P1.11, R12.2, U1.49 (PA14), U4.8 (!KILL!)
PA15: P1.27, U1.50 (PA15)
PB0: P2.15, U1.26 (PB0)
PB1: P2.13, U1.27 (PB1)
PB2: BOOT1.1, P2.11, R4.2, R13.1, U1.28 (PB2)
PB3: P1.17, U1.55 (PB3)
PB4: P1.15, U1.56 (PB4)
PB5: P1.13, U1.57 (PB5)
PB6: P1.9, U1.58 (PB6)
PB7: P1.7, U1.59 (PB7)
PB8: P1.5, U1.61 (PB8)
PB9: P1.3, U1.62 (PB9)
PB10: P2.9, U1.29 (PB10)
PB11: P2.7, U1.30 (PB11)
PB12: P2.18, U1.33 (PB12)
PB13: P2.16, U1.34 (PB13)
PB14: P2.14, U1.35 (PB14)
PB15: P2.12, U1.36 (PB15)
PC0: P1.12, U1.8 (PC0)
PC1: P1.14, U1.9 (PC1)
PC2: P1.16, U1.10 (PC2)
PC3: P1.18, U1.11 (PC3)
PC4: P1.20, U1.24 (PC4)
PC5: P1.22, U1.25 (PC5)
PC6: P1.24, U1.37 (PC6)
PC7: P1.26, U1.38 (PC7)
PC8: P1.10, U1.39 (PC8)
PC9: P2.10, U1.40 (PC9)
PC10: P1.25, U1.51 (PC10)
PC11: P1.23, U1.52 (PC11)
PC12: P1.21, U1.53 (PC12)
PC13: C22.1, P1.6, R5.1, SW1.1, SW1.2 (1), U1.2 (PC13)
PD2: P1.19, U1.54 (PD2)
PWR_ON: P1.28, P2.28, POWER.1, POWER.2 (1), U4.2 (!PB!)
RESET#: C21.1, P1.1, P2.1, R1.1, RESET.1, RESET.2 (1), U1.7 (NRST)
RSV0: P2.3, RSV0.P$1
RSV1: P2.5, RSV1.P$1
RSV2: P2.17, RSV2.P$1
RSV3: P2.19, RSV3.P$1
STAT: R8.2, U3.1 (STAT)
VBAT: C20.1, CN1.1, Q2.3 (D), U3.3 (VBAT)
VCC: P1.30, P1.32, P2.30, P2.32, Q1.3 (D), U2.3 (VI)
VCC_3V3: BOOT0.2, BOOT1.2, C1.1, C2.1, C3.1, C4.1, C5.1, C6.1, C11.1, C17.1, C18.1, C19.1, P1.29, P1.31, P2.29, P2.31, R1.2, R2.1, R3.2, R5.2, R12.1, R14.1, U1.13 (VDDA), U1.19 (VDD1), U1.32 (VDD2), U1.48 (VDD3), U1.64 (VDD4), U2.2 (VO)
VCC_BKUP: R14.2, U1.1 (VBAT)
VCC_SEL: D5.C, Q1.2 (S), Q2.2 (S), R7.1, U4.1 (VIN)
VCC_USB: F1.1, U$1.1 (VBUS)
VCC_USBF: C16.1, D5.A, F1.2, Q2.1 (G), R10.1, U3.4 (VIN)

Notes on the sheet:
Ichg = 1000V / R9

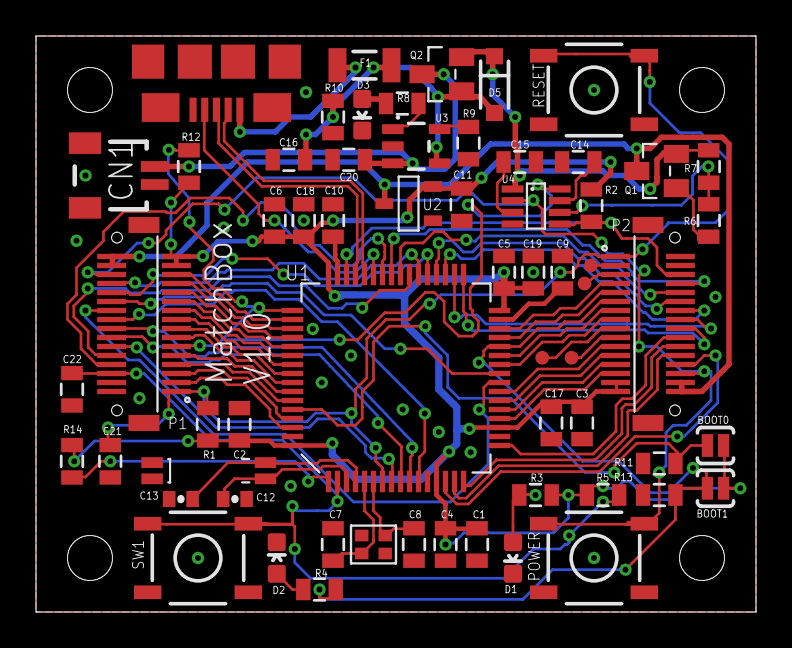
[picture p29: board matchbox_cpu_v10.brd from above]

Board: 2 copper layers, 40.0 x 32.0 mm, 62 parts (0 on the bottom side), 77 nets.
