jaggies/matchbox/cad/pcb/kicad/cpu/v2.0/stm32mx/stm32mx.ioc

Mcu.UserName=STM32H743VGTx
PC10.Signal=SPI3_SCK
PC12.Signal=SPI3_MOSI
PB11.Signal=I2C2_SDA
PB13.Signal=SPI2_SCK
PB15.Signal=SPI2_MOSI
PD13.Signal=I2C4_SDA
PA12.Signal=USB_OTG_FS_DP
PB6.Signal=I2C1_SCL
PC7.Signal=USART6_RX
PD8.Signal=USART3_TX
PE1.Signal=UART8_TX
PE13.Signal=SPI4_MISO
PB7.Signal=I2C1_SDA
PE10.Signal=GPXTI10
PA0.Signal=PWR_WKUP0
PA6.Signal=SPI1_MISO
PD12.Signal=I2C4_SCL
PA10.Signal=USB_OTG_FS_ID
PD15.Signal=GPXTI15
PC11.Signal=SPI3_MISO
PC6.Signal=USART6_TX
PD9.Signal=USART3_RX
PA9.Signal=USB_OTG_FS_VBUS
PE11.Signal=SPI4_NSS
PB10.Signal=I2C2_SCL
PB14.Signal=SPI2_MISO
PA5.Signal=SPI1_SCK
PE14.Signal=SPI4_MOSI
PE15.Signal=GPIO_Output
PE0.Signal=UART8_RX
PE12.Signal=SPI4_SCK
PD14.Signal=GPXTI14
PA4.Signal=SPI1_NSS
PA11.Signal=USB_OTG_FS_DM
PB12.Signal=SPI2_NSS
PA7.Signal=SPI1_MOSI
