jaggies/matchbox/(commit log)

2016-04-28 Blinking light + power off works
2016-05-01 Switch back to USB Device class.
2016-05-01 Add FAT, Threading and USB virtual console.
2016-05-01 Switch back to 72MHz because virtual console (USB serial) broke :(
2016-05-03 Use alternate SPI2 pin mapping.
2016-05-03 Add I2C module and USART2 to replace USART3
2016-05-07 Add fatfs support for SD card. Enable ADC1 on channel 15 for battery monitor.
2016-05-07 USB Serial working. Prints "Hello, World!", yay.
2016-05-07 Fix USB hang - increase thread stack size to 256B - more interesting test case
2016-05-08 Misc changes to USB serial driver - Don't busy wait for USB hardware to be ready. - fix isatty() to know about USB serial - attempt to get read working.
2016-05-12 Use interrupts on buttons Enable asserts Use constants for defining SW1/SW2 Introduce version number for different baards. Increase thread stack to 2kB
2016-05-18 Add continuous conversion ADC interrupt handler.
2016-05-18 Add weak main, setup and loop for Arduino-like linkage.
2016-05-27 Add brute-force setPixel routine and draw sequential color frames.
2016-05-28 Make simple oscilloscope using built-in ADC and memory display
2016-05-28 Add hardware SPI support for memory display - remove unused peripherals (SPI3, I2C2, etc.) - disable broken USB read() for now
2016-05-28 Attempt to update memory display asynchronously using SPI IRQ
2016-05-29 Async SPI one step closer - add more display drawing tests - clear pending interrupts in handler (oops) - don't exit irq handler w/o starting new xfer - use line buffer
2016-05-29 Cleanup async SPI code - eliminate temporary line buffer
2016-06-12 Experiment with battery voltage monitor.
2016-06-12 Add new libraries to build - Arduino-compatible library (define pins, main, setup and loop) - Brad's IRISGL implementation - MatchBox helper library (Sharp memory display, utils, etc.) - Rasterizer (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
2016-06-16 Add frame-at-a-time SPI transfer mode.
2016-06-18 Fix warning about new framebuffer structure.
    [lcdtest.c]
2016-06-18 Refactor PIN io to use device-independent methods
2016-06-18 Fix control signals in matchbox library.
    [lcdtest.c]
2016-06-20 Soft SPI working again.
2016-06-20 Got SPI LCD refresh working again! - Interrupt handlers need to be defined extern "C" to be activated
2016-07-05 Add stock STM32 discovery library for stm4xx devices
2016-07-06 Integrate STM32Cube_FW_F4_V1.12.0 HAL library
2016-07-06 Use STM32MX to generate simple blink program
2016-07-09 Simplify sample apps.
2016-07-10 Move devices into matchbox class - Make structures static members to workaround suspected malloc() bug.
    [lcdtest.cpp]
2016-07-10 Fix bug in lcd line rendering and improve clear() performance on color LCD.
    [lcdtest.cpp]
2016-07-11 Move device handles into MatchBox class & improve system stability.
    Turns out auto-generated code relies on global variables for
    initialization. By storing them in .bss, they get that for free.
    The fix is to manually initialize non-global variables.
2016-07-13 Add SPI class to matchbox library (untested).
2016-07-13 Add SPI class to matchbox library and update lcd test case
2016-07-15 Move lcd/spi instantiation to StartDefaultTask()
2016-07-15 Add extern "C" wrapper in adc HAL header.
2016-07-15 Add ADC abstraction layer.
2016-07-15 Enable power pin in matchbox library.
    The power pin has an external pull-up resistor. This
    just ensures it's enabled and driven so we can shut down
    easily with just a pinWrite().
2016-07-15 Add doReceive() test code to usb serial driver for now.
2016-07-15 Simplify lcdtest example and remove usart/i2c code from MatchBox class.
2016-07-15 Workaround for missing USB.
    It appears that at least one USART device needs to be initialized or USB
    never shows. This hacks it back into matchbox.
2016-07-16 Initialize row data once per clear instead of once per SPI frame.
2016-07-16 Ignore mac files and project output from STM32CubeMX
2016-07-17 Add Button class for using GPIO pins with interrupts.
2016-07-17 Transmit buffer should be const in SPI functions.
2016-07-18 Add double-buffering / frame sync support
2016-07-20 Add fluent configuration API to SPI class.
2016-07-20 Check for null button before calling handler.
2016-07-20 Add Nordic SDK for arduino (to be ported)
2016-07-20 Update Arduino-compatibility library with stubs
2016-07-20 Include stm32f4xx_hal.h instead of configuration file
2016-07-22 Make Button class more general to allow reading/writing as well as auxiliary functions.
2016-07-22 Reduce size of Pin class
2016-07-22 Add simple hello test case using new Pin class.
2016-07-22 Improve arduino compatibility functions (pinMode(), delay())
2016-07-23 Deconflict PA9/PA10 so they can be used by BT board
    Prior to this change, USBSerial magically and inexplicably
    depended on usart1 being initialized on PA9/10.
    This was due to the unused VBUS sensing feature, which is now disabled.
2016-07-23 Resolve pin conflict with COMM signal when BT is installed.
2016-07-23 Enable activity LED.
2016-07-24 Add new SensorService and use it to send data. Currently seems to be limited to about 3Hz :(
2016-07-24 Do pipe and credit check in sendData() and use real data from ADC.
2016-07-31 Add current time and uart services to BLE.
2016-08-04 Attempt to use more channels - fix channel3 name. - inject a sawtooth instead of actual adc data.
2016-08-04 Slow down ADC clock
2016-08-07 Add basic SDIO test app & BSP to build - use pull-ups on all SDIO pins - Fix Matchbox BSP (Board Support Package) to use det pin and IRQ - SDIO seems to work. Prints mfg and reasonable serial #.
2016-08-13 Fix build dependency on fatfs test case.
2016-08-13 Improve fatfs test case - Search for unused filename for logging. - Write at 1000Hz to flesh out write errors faster
2016-08-13 Try some additional ffconf parameters - enable volume label functions - strfunc w/o cr-lf conversion - relax non-DMA alignment - fix type-os.
2016-08-14 Enable BLE_PRESENT in lcd driver to free a couple pins.
2016-08-14 Use low-speed for microSD detect pin to help with debouncing.
2016-08-15 More robust fatfs testing. - add countdown timer to wait for SD - only write 4MB of data and then close the file
2016-08-15 Tweak sd card timing parameters
    Looks like there's a known issue with SDIO producing SD_TX_UNDERRUN
    with non-DMA transfer. Sadly, the recommendation is to either use DMA -
    which doesn't work - or slowing down the clock significantly. This change:
    - reduces the clock speed to 12MHz from 24MHz
    - reduce the IO pin speed from GPIO_SPEED_FREQ_VERY_HIGH to _MEDIUM
2016-08-17 Add basic HAL_SDIO test case.
2016-08-17 Enable HW flow control in SDIO test app. - still get CRC check errors
2016-08-20 Rename sdio to sdio_bsp and add DMA test
2016-08-20 Add SD card dma initialization and blinkOfDeath function for debug for when USB not available.
2016-08-20 Add IRQ handlers, change SDIO/DMA priorities and add more debugging.
2016-08-21 Disable SDIO HW flow control due to bug in stm32f415
    This disables HW flow control and works around the resulting TX underflow
    error by disabling interrupts while filling the tx fifo. This is a
    bit of a kludge until I can find another workaround - like getting DMA
    working.
    This allows SDIO to run at full speed (24MHz) without errors, but probably
    blocks IRQs for an unacceptably long time in some cases :/
    Errata from ST:
    When enabling the HW flow control by setting bit 14 of the SDIO_CLKCR register to ‘1’,
    glitches can occur on the SDIOCLK output clock resulting in wrong data to be written
    into the SD/MMC card or into the SDIO device. As a consequence, a CRC error will be
    reported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
    [sdio_test.cpp]
2016-08-21 Enable full clock speed and disable hw flow control in matchbox BSP layer
    Fixes fatfs application. Tested at full speed!
2016-08-21 Add performance benchmark to raw io tests.
    Noisy due to poor resulution of timer.
2016-08-27 Get SDIO DMA working! - SD IRQ priority must be lower number than DMA. - Make interal SDIO_IRQHandler weak symbol. - Eliminate software delay loops - HAL_SD_Check*Operation is in counts, not ms. Pick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
2016-08-27 Fix memory alignment and rand issue - Memory alignment was accidentally set to peripheral constant - rand() was being assinged to words instead of bytes
    [sdio_dma_test.cpp]
2016-08-27 Get fatfs test working again (w/o DMA)
2016-08-27 Use DMA by default for sdio fatfs driver.
2016-08-27 Try different DMA priorities.
2016-09-02 Add clock divisor support to SPI.
2016-09-02 Fix LCD driver to properly toggle common each shown frame.
2016-09-04 Minor LCD improvements - allow display to be disabled to save power (~5mA) - add destructor
2016-09-11 Enable polling mode for ADC when callback == null
2016-09-11 Save some power if freq < 144MHz
2016-09-15 Enable LCD to be shut down to conserve power.
2016-09-18 Use binary search to find character to print on LCD.
2016-11-06 Enable Segger IDE debugging - fix path for ranlib - don't use SWD pins (PA13/PA14) - compile -Os
    [lcdtest.cpp]
2016-12-11 Fix debug collision in Eclipse
    [bletest.cpp, nrfclass.cpp]
2019-06-15 Fix debugging printf
    error() only logs if debugging is enabled
    since it's pointless to log to a dead serial port.
2020-05-25 Initial battery design
    [battery.FCStd]
2020-05-25 Slightly improved battery holder
    [battery.FCStd]
2020-05-25 Slightly deeper battery holder
    [battery.FCStd]
2020-05-25 Battery holder with basic cuts (no extrusions)
    [battery.FCStd]
2020-05-25 Battery holder with basic cuts and removed material
    [battery.FCStd]
2020-05-25 Added button cutouts
    [battery.FCStd]
2020-05-25 Add cuts, but don't remove material yet
    [battery.FCStd]
2020-05-25 Add cutout pockets
    [battery.FCStd]
2020-05-25 More button cutout work
    [battery.FCStd]
2020-05-25 Add retainer extrusion
    [battery.FCStd]
2020-05-25 Simplify retainer
    [battery.FCStd]
2020-05-25 Switch to 1.5mm wall thickness
    [battery.FCStd]
2020-05-25 More wall tweaks
    [battery.FCStd]
2020-05-25 And more tweaks
    [battery.FCStd]
2020-05-25 More battery compartment tweaks
    [battery.FCStd]
2020-05-25 Tweaks to make battery compartment printable
    [battery.FCStd]
2020-05-25 More final
    [battery.FCStd]
2020-05-25 More tweaks
    [battery.FCStd]
2020-05-25 Checkin after print verification
    [battery.FCStd]
2020-05-25 Minor corrections after print verification
    [battery.FCStd]
2020-05-25 More corrective tweaks
    [battery.FCStd]
2020-05-25 Try tighter print tolerances
    [battery.FCStd]
2020-05-25 Slight variation on tolerance relaxation
    [battery.FCStd]
2020-05-25 Slight variation on tolerance relaxation.. part 2
    [battery.FCStd]
2020-05-25 New battery compartment design
    [newbattery.FCStd]
2020-05-25 Add LCD cutouts to battery compartment
    [newbattery.FCStd]
2020-05-25 Add buttons to new battery compartment
    [newbattery.FCStd]
2020-05-25 Add cutouts behind buttons
    [newbattery.FCStd]
2020-05-25 Add battery wire cutout
    [newbattery.FCStd]
2020-05-25 More tweaks to wire cutout
    [newbattery.FCStd]
2020-05-25 Add finishing touches
    [newbattery.FCStd]
2020-05-25 Add display case
    [display.FCStd]
2020-05-25 Display case tweaks
    [display.FCStd]
2020-05-25 Display finishing tweaks
    [display.FCStd]
2020-05-25 Minor display tweaks
    [display.FCStd]
2020-05-25 Switch to 1.9mm wall for display
    [display.FCStd]
2020-05-25 More 1.9mm tweaks
    [display.FCStd]
2020-05-25 1.9mm wall cleanup
    [display.FCStd]
2020-05-25 1.9mm wall cleanup.. continued
    [display.FCStd]
2020-05-25 Switch to 1.75mm wall thickness
    [display.FCStd]
2020-05-25 Switch to 1.75mm wall thickness... continued
    [display.FCStd]
2020-05-25 Switch to 1.5mm wall
    [display.FCStd]
2020-05-25 Display 1.5mm wall tweaks
    [display.FCStd]
2020-05-25 More 1.5mm wall display tweaks
    [display.FCStd]
2020-05-25 Switch back to 1.75mm wall
    [display.FCStd]
2020-05-25 Shrink display retaining pins to 1.22mm
    [display.FCStd]
2020-05-25 More 1.75mm wall tweaks
    [display.FCStd]
2020-05-25 Sketch out corner piece
    [corner.FCStd]
2020-05-25 First corner piece
    [corner.FCStd]
2020-05-25 Corner tinkering
    [corner.FCStd]
2020-05-25 More corner tinkering
    [corner.FCStd]
2020-05-25 Initial corner with peg design
    [corner.FCStd]
2020-05-25 Tweaked corner with pegs
    [corner.FCStd]
2020-05-25 More non-screw corner tweaks
    [corner.FCStd]
2020-05-25 Add screw corner pieces with hole
    [screw_corner.FCStd]
2020-05-25 Tweak screw corners
    [screw_corner.FCStd]
2020-05-25 Add new corner design with 1.75mm wall
    [new_corner.FCStd]
2020-05-25 New corner design tweaks
    [new_corner.FCStd]
2020-05-25 Relax tolerance with smaller 2.44mm pin
    [new_corner.FCStd]
2020-05-25 Tweaks to 2.44mm pin
    [new_corner.FCStd]
2020-05-25 Rename newbattery -> new_battery
    [new_battery.FCStd]
2020-05-25 Add lower half without battery compartment
    [no_battery.FCStd]
2020-05-25 No battery case tweaks.
    [no_battery.FCStd]
2020-05-25 Lower battery case with button correction
    [no_battery.FCStd]
2020-05-25 More button tweaks to lower non-battery case.
    [no_battery.FCStd]
2020-05-25 Rename standard corner to peg-corner
    [peg_corner.FCstd]
2020-05-25 First jimduino version.
    [jimduino.brd, jimduino.sch]
2020-05-25 Move components and switches around.
    [jimduino.brd, jimduino.sch]
2020-05-25 Add LIPO charging circuit.
    [jimduino.brd, jimduino.sch]
2020-05-25 Add more intelligent power switching and improve schematic layout.
    [jimduino.brd, jimduino.sch]
2020-05-25 CHeckpoint for Stencil generation
    [jimduino.brd]
2020-06-06 Release candidate 0
    [jimduino.brd, jimduino.sch]
2020-06-06 Release Candidate 1
    [jimduino.brd, jimduino.sch]
2020-06-06 Switch to 0402 capacitors
    [jimduino.brd, jimduino.sch]
2020-06-06 Release Candidate 2
    [jimduino.brd, jimduino.sch]
2020-06-06 New USB connector
    [jimduino.brd, jimduino.sch]
2020-06-06 unknown changes
    [jimduino.brd, jimduino.sch]
2020-06-06 Final v1.0 cpu
    [matchbox_cpu_v10.brd, matchbox_cpu_v10.sch]
2020-06-06 Use new side switches
    [matchbox_cpu_v11.brd, matchbox_cpu_v11.sch]
2020-06-06 Side button improvement
    [matchbox_cpu_v11.brd, matchbox_cpu_v11.sch]
2020-06-06 Change capacitance values. Final build?
    [matchbox_cpu_v11.brd, matchbox_cpu_v11.sch]
2020-06-06 Add CPU version 1.2
    [matchbox_cpu_v12.brd, matchbox_cpu_v12.sch]
2020-06-06 Move pcb to eagle directory
    [matchbox_cpu_v10.brd, matchbox_cpu_v10.sch, matchbox_cpu_v11.brd, matchbox_cpu_v11.sch, matchbox_cpu_v12.brd, matchbox_cpu_v12.sch]
2020-06-06 Add breakout board
    [breakout.brd, breakout.sch]
2020-06-06 Tweak board
    [breakout.brd]
2020-06-06 More board tweaks
    [breakout.brd]
2020-06-06 Better routing
    [breakout.brd, breakout.sch]
2020-06-06 Breakout board v0.1 Release Candidate
    [matchbox_bob_v01.brd, matchbox_bob_v01.sch]
2020-06-06 Matchbox breakout board v1.0 (40x32mm)
    [matchbox_bob_v10.brd, matchbox_bob_v10.sch]
2020-06-06 Tweaks to BOB v1.0
    [matchbox_bob_v10.brd, matchbox_bob_v10.sch]
2020-06-06 Add passthrough to v1.0 BOB
    [matchbox_bob_v10.brd, matchbox_bob_v10.sch]
2020-06-06 Add matchbox BOB v1.1
    [matchbox_bob_v11.brd, matchbox_bob_v11.sch]
2020-06-06 Initial matchbox display schematic & board
    [matchbox_dpy_sm_v01.brd, matchbox_dpy_sm_v01.sch]
2020-06-06 Tweak display board v01
    [matchbox_dpy_sm_v01.brd]
2020-06-06 Add display board v1.0
    [matchbox_dpy_sm_v10.brd, matchbox_dpy_sm_v10.sch]
2020-06-06 Add display board v1.1
    [matchbox_dpy_sm_v11.brd, matchbox_dpy_sm_v11.sch]
2020-06-06 Initial Bluetooth LE board (38x30mm)
    [matchbox_ble_v01.brd, matchbox_ble_v01.sch]
2020-06-06 BT tweaks
    [matchbox_ble_v01.brd, matchbox_ble_v01.sch]
2020-06-06 More progress on v01 BLE
    [matchbox_ble_v01.brd]
2020-06-06 Switch BLE to 40x32mm form factor
    [matchbox_ble_v01.brd, matchbox_ble_v01.sch]
2020-06-06 Add VDDA supply (WIP)
    [matchbox_ble_v01.brd, matchbox_ble_v01.sch]
2020-06-06 Final BLE board
    [matchbox_ble_v01.brd, matchbox_ble_v01.sch]
2020-06-06 Rename comm directory to bluetooth
    [matchbox_ble_v01.brd, matchbox_ble_v01.sch]
2020-06-08 Fix bit rot in lcdtest.
    [lcdtest.cpp]
2020-06-08 Add span() and special case clear performance for all black/all white
2020-06-10 Add thread test case.
2020-06-11 Import STM32Cube_FW_F4_V1.25.0
2020-06-11 Get code roughly compiling.
    Import new ffconf.h
    Import new std32f4xx_hal_conf.h
    Fix renamed structures for SD files.
    Update USB_LL to use uint32_t size transfers (may fix old hang bug)
    Document hal_msp.c overloads
    LCDtest works, but is slow.
    Nothing else tested
    [lcdtest.cpp, pincheck.cpp, sdio_dma_test.cpp, sdio_test.cpp]
2020-06-11 All code now compiles and links.
    Threadtest and LCDtest both run, but the latter is really slow
2020-06-12 Create bridge device handlers for SD and USB (WIP)
    Hello.cpp works, but hangs after sending text.
2020-06-12 Fix USB serial
    Looks like they added a method to know when transmission is
    complete. As it was undefined, it would go off the rails and crash.
2020-06-14 Fix USBSerial read (woot!)
    Formerly, the protocol wasn't implemented correctly, which caused
    an on-device hang when the USB FIFO was full.
    stdio::read() should now be able to read from the fifo (untested)
2020-06-14 Fix slow drawing on lcdtest by lowering SPI frequency
    Unknown why this only happens on STM32 V1.25. Presumably
    another IRQ is firing frequently and blocking this one.
    Investigation for another day...
    [lcdtest.cpp]
2020-06-16 Use LED to show callbacks instead of printf, which results in bad things
2020-06-16 sdio_dma_test works!!!
    The code required the addition of a loop to ensure non-overlapping
    DMA transfers to the SD cad. In short, follow the same code in
    sd_diskio_dma_rtos_bspv1.c which loops on BSP_SD_GetCardState()
    to check the transfer state after each operation.
    [sdio_dma_test.cpp]
2020-06-16 Switch back to random data test case.
2020-06-16 Update sdio_test with same completion logic as sdio_dma_test.
    Still has issues writing, especially on startup. Guessing these
    are related to the 'f415 errata about hardware flow control bugs.
    [sdio_test.cpp]
2020-06-16 Fix BSP SDIO test case (DMA only)
2020-06-16 Clean up fatfs test printout
2020-06-17 Add IDLE handler hook for apps to use to achieve lower power.
    Have LCD code yield the process while waiting for swapbuffers to occur.
    This cut the power in half for threadtest (from 72.9mA to 36.1mA)
    [threadtest.cpp]
2020-06-17 Use osMessageQueue in threadtest.
    Only yielded minor improvement to 33.1mA (No SD card)
2020-06-20 Use pre/post sleep hooks to further reduce power to 22.9mA
    Test conditions: matchbox CPU only (no daughter cards).
2020-06-20 Reduce the amount of on time from 50ms to 5ms.
    Test runs at 22.7mA at 168MHz.
2020-06-20 Some further power improvements
    16MHz: 8.9mA
    24MHz: 9.1mA
    168MHz: 22.7mA
    Test condition: CPU only (no daughter cards)
2020-06-20 Get RTC running (WIP)
    Runs on internal oscillator, but way too fast.
    [rtc.cpp]
2020-06-20 Get RTC working on internal oscillator (WIP)
    Assumes internal oscillator is 16MHz, so 1s = 32768 counts
    32768 = 4096 * 8, so use 4095 and 7 for scale values.
    [rtc.cpp]
2020-06-20 RTC app now prints to LCD instead of USB
2020-06-20 Improve putString/putChar routines to track raster position between calls.
    Should also improve performance. Still more to do.
2020-06-20 USB delay require to prevent hang (fixme!)
    [rtc.cpp]
2020-06-22 Hide PC14 and PC15 since they're used for the LSE oscillator
    [pincheck.cpp]
2020-06-22 Attempt to fix clock selection from LSI (WIP)
    [rtc.cpp]
2020-06-22 LSE clock is probably working now, but needs a higher divisor than expected. The instructions in code want to be 1/1000th of the current value (32 instead of 32768)
2020-06-22 Save some power using larger divisor from datasheet.
    Also, ensure rtc app and main library use the same divisor sources.
2020-06-22 Update makefont script to work with python 3
    Use "pip install pillow" to install PIL replacement
    [makefont.py]
2020-06-22 Print in differnt fonts and ensure LCD command buffer gets updated in case pixels overflow into command area
2020-06-24 Only wait for vertical retrace if in double-buffer mode.
    Also, force-updates lcd SPI buffer in double buffer mode in
    case it gets overwritten by drawing commands. TODO: clip so this
    can't happen.
2020-06-24 Move RTC initialization to worker thread.
2020-06-24 Attempt to fix time loss after every reset.
    Before this change, every reset caused the clock to loose nearly a
    second after reset. After this change, it still looses time unless
    we transition from the matchbox entrypoint to the bootloader
    to normal state. Likely memory state corryption.
    Will probably work fine with battery backup, but needs investigation.
2020-06-24 Attempt to fix hang when printing to USB before USB connects.
    - Fix bug where UsbSerial::receive() would incorrectly decrement nchar while waiting.
    - Add 5s timeout for USB write operations.
    [rtc.cpp]
2020-06-24 Finally solve RTC losing 1 second per reset problem.
    The power-on reset flag was persisting since nobody clears it.
    So now we do...
2020-06-25 Enable SD_DET pin in HAL_SD_MspInit() and only look at falling edge for IRQ
2020-06-26 Add headers to better support multiple board revisions
2020-07-01 Add CPU v2 (WIP)
    [matchbox_cpu_v20.kicad_pcb, matchbox_cpu_v20.sch]
2020-07-01 Add v1.0 bluetooth project (WIP)
    [matchbox_ble_v10.kicad_pcb, matchbox_ble_v10.sch]
2020-07-01 More CPU v20 changes
    [matchbox_cpu_v20.kicad_pcb]
2020-07-02 Routed CPU v2.0. Needs cleanup.
    [matchbox_cpu_v20.kicad_pcb]
2020-07-02 Lots of cleanup work on CPU v2
    [matchbox_cpu_v20.kicad_pcb, matchbox_cpu_v20.sch]
2020-07-02 Cleaned up decoupling caps and layout to maximize copper area.
    [matchbox_cpu_v20.kicad_pcb]
2020-07-02 Add "tag-connect" JTAG connector to schematic
    [matchbox_cpu_v20.sch]
2020-07-02 Hide temporary kicad files
2020-07-02 Basic CPU v2.0 with connections and some cleanup work.
    [matchbox_cpu_v20.kicad_pcb, matchbox_cpu_v20.sch]
2020-07-02 Add STM32CubeMX configuration (WIP)
2020-07-03 Remove unnecessary RESET# pin pullup
    [matchbox_cpu_v20.kicad_pcb, matchbox_cpu_v20.sch]
2020-07-03 Add STM32CubeF4 as a submodule
2020-07-03 Improve ground fill polygons.
    [matchbox_cpu_v20.kicad_pcb, matchbox_cpu_v20.sch]
2020-07-03 Clean up CPUv2 component labels
    [matchbox_cpu_v20.kicad_pcb]
2020-07-03 CPUv2 functional improvements
    De-conflict interrupt lines
    PC13 for VCC_MON
    PD14 for SW1
    PD15 for SW2
    PE15 for PWR_KILL#
    Wire up VBAT to VCC_BKUP through 100k resistor
    Frees PC5(VCC_MON) and PC4(PWR_KILL#)
    [matchbox_cpu_v20.kicad_pcb, matchbox_cpu_v20.sch]
2020-07-04 Remove links from lib/hal directory
    Jamfiles are now distributed in STM32CubeF4 directory.
2020-07-04 Add Vref bypass caps.
    [matchbox_cpu_v20.kicad_pcb, matchbox_cpu_v20.sch]
2020-07-04 Fix some DRC errors
    Still left: holes and custom parts.
    [matchbox_cpu_v20.kicad_pcb, matchbox_cpu_v20.sch]
2020-07-04 Update footprints with KiCAD parts
    [matchbox_cpu_v20.kicad_pcb, matchbox_cpu_v20.sch]
2020-07-05 Improved bypass strategy: vias with local caps.
    [matchbox_cpu_v20.kicad_pcb, matchbox_cpu_v20.sch]
2020-07-05 Eliminate some "missing courtyard" errors by using components in kicad library
    [matchbox_cpu_v20.kicad_pcb, matchbox_cpu_v20.sch]
2020-07-05 Fix all labels and 3D rendering
    [matchbox_cpu_v20.kicad_pcb, matchbox_cpu_v20.sch]
2020-07-05 Add 3d crysta modesl and use correct Hirost connector on CPUv2
    [matchbox_cpu_v20.kicad_pcb]
2020-07-05 Add 3d models to project
    [10118192C.stp, 5025700893.stp, ABM11.STEP, DF12(3.0)-32DP-0.5V.stp, DF12-32DS-0.5V.stp, SM02B-SRSS-TB.IGS, SM02B-SRSS-TB.STEP, SM02B-SRSS-TB_white.STEP]
2020-07-05 Bypass cap improvements for STM32 part
    [matchbox_cpu_v20.kicad_pcb]
2020-07-05 Minor ground plane improvements
    [matchbox_cpu_v20.kicad_pcb]
2020-07-05 Fix all DRC errors with undefined courtyards
    [matchbox_cpu_v20.kicad_pcb]
2020-07-06 Re-update all 3d parts after importing cleared them. Sigh.
    [matchbox_cpu_v20.kicad_pcb]
2020-07-06 P3 and P2 got swapped. Swap them back.
    [matchbox_cpu_v20.kicad_pcb, matchbox_cpu_v20.sch]
2020-07-06 Add D1 3d model back in.
    [matchbox_cpu_v20.kicad_pcb, matchbox_cpu_v20.sch]
2020-07-06 Add surface mount 0603 LED 3d models
    [matchbox_cpu_v20.kicad_pcb]
2020-07-06 Set gerber parameters
    [matchbox_cpu_v20.kicad_pcb]
2020-07-06 Updated RESET and BOOT0 since Kicad insists on changing the name every time I update the PCB
    [matchbox_cpu_v20.kicad_pcb]
2020-07-07 Add IO to P3 and P4.
    [matchbox_cpu_v20.kicad_pcb, matchbox_cpu_v20.sch]
2020-07-07 Add place-holder SOIC-8 QPSI components
    [matchbox_cpu_v20.sch]
2020-07-07 Fully routed QSPI devices
    [matchbox_cpu_v20.kicad_pcb]
2020-07-07 Major ground plane cleanup.
    [matchbox_cpu_v20.kicad_pcb]
2020-07-07 Add decoupling capacitors for QSPI parts
    [matchbox_cpu_v20.kicad_pcb, matchbox_cpu_v20.sch]
2020-07-07 More ground tweaking after attempting to add JTAG connector. Not enough room!
    [matchbox_cpu_v20.kicad_pcb, matchbox_cpu_v20.sch]
2020-07-07 Add STM32CubeH7 submodule
2020-07-08 Finishing touches
    - Move switches to +6mm from mounting holes
    - Use text instead of references for silkscreen
    - Add debug test points
    - Add test points for serial port 1
    - Clean up all silk screen labels
    [matchbox_cpu_v20.kicad_pcb, matchbox_cpu_v20.sch]
2020-07-08 Almost ready for fabrication. Update images with new PCB.
    [matchbox_cpu_v20.kicad_pcb]
2020-07-08 Fix misaligned fill polygons. They now match the cut outline.
    [matchbox_cpu_v20.kicad_pcb]
2020-07-08 Ignore temporary gerber files
2020-07-08 Fix wiring error on SD card (VDD/VSS swapped!)
    [matchbox_cpu_v20.kicad_pcb, matchbox_cpu_v20.sch]
2020-07-08 Tune ground plane around SD card
    [matchbox_cpu_v20.kicad_pcb]
2020-07-08 Minor cleanup before sending out for fab - Replace STM32H743VI with STM32H753VI which is currently easier to get - Fix mislabeled CN1 issue (now called BATT1) - Fix mislabeled wires on STM part for 1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
    [matchbox_cpu_v20.kicad_pcb, matchbox_cpu_v20.sch]
2020-07-08 STM32H7 is now added as a submodule, remove gitignore for it.
    [matchbox_cpu_v20.kicad_pcb]
2020-07-09 Fix footprint issues on P1, P2 and P3 as well as CPU
    After uploading, I noticed some traces would hang off the respective
    pads, which will make soldering error-prone on these parts. Too late
    for this batch, maybe next.
    [matchbox_cpu_v20.kicad_pcb, matchbox_cpu_v20.sch]
2020-07-09 Looks like P2 & P3 got swapped again. Flip them back.
    [matchbox_cpu_v20.kicad_pcb, matchbox_cpu_v20.sch]
2020-07-21 Add digikey part numbers to schematic and create script to parse them into bom
    [matchbox_cpu_v20.sch]
2020-07-21 Remove dependency on copying Jamfiles into STM32CubeF4 tree
    Compiles, but untested.
2020-07-21 Move device-specific targets into target directories
2020-07-21 Refactor build to target separate directories for different devices.
    Compiles for target=STM32F4XX by default (untested)
    Compiles the H7 HAL driver but barfs on stm32f4xx-specific bridge code
    which will need to be partitioned.
2020-07-21 Create common stm32.h header to include common headers based on TARGET
    Fix some more stuff to work in prep for H7 build (WIP)
2020-07-22 Add LCSC part numbers and take snapshot of working gerber settings
    [matchbox_cpu_v20.kicad_pcb, matchbox_cpu_v20.sch, matchbox_cpu_v20_bom.csv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]
2020-07-24 Add script to generate header from cubemx pin csv file.
    [stm32f415.csv]
2020-07-24 Use pin mapping from STMCubeMX tool
2020-07-24 Remove dependency of lcd.h on board declarations.
2020-07-24 Remove more device dependencies
    Also fixes race condition in build caused by multiple occurrences of port.c
    [blink.c]
2020-07-25 Add rule to automatically build pin map file from STMCubeMX csv file.
    Use Pinout->"Export pinout without Alt. functions" to generate csv file.
2020-07-25 More device-specific build stuff for H7 vs F4
    [stm32f415.csv, stm32h743.csv]
2020-07-25 Add configuration for stm32f415 and generate code
2020-07-25 Get blink test case compiling on STM32H7 target.
